Houman1368/Waste/uvc-arm-stand/docs/specifications.html

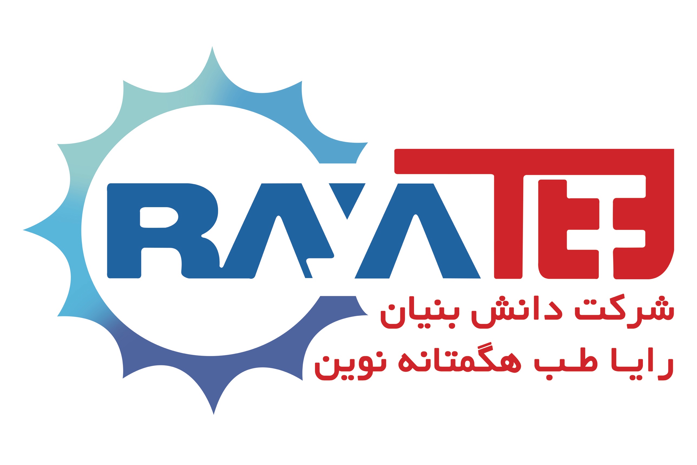
[picture p5: uvc-arm-stand/video/assets/logo_rayateb.jpg]
Rayateb


# مشخصات فنی کامل

پایه UV-C چهاربازو ۳۰ وات · طرح نهایی · ۱۸ مهر ۱۴۰۵ · همهٔ ابعاد به میلی‌متر

### فهرست

1. مشخصات کلی دستگاه
2. نقشهٔ کلی و نقشهٔ سیم‌کشی
3. نقشه و مشخصات قطعات ساختنی
4. مشخصات فنی قطعات برقی
5. مشخصات فنی یراق و قطعات مکانیکی خریدنی
6. پیچ و مهره، استاندارد و گشتاور
7. جوشکاری، تلرانس و رنگ
8. تست‌های تحویل

## ۱. مشخصات کلی دستگاه

پارامتر | مقدار
نوع دستگاه | پایهٔ سیار ضدعفونی سطوح و هوا با ۴ لامپ UV-C، چهار بازوی مستقل
لامپ | ۴ × UV-C T8، ۳۰ وات، ۲۵۳٫۷ نانومتر، پایه G13
برق ورودی | ۲۳۰ ولت AC، ۵۰ هرتز، تک‌فاز با ارت
توان مصرفی | حدود ۱۳۵ تا ۱۴۰ وات (۴ × ۳۰ وات + تلفات باالست)؛ جریان حدود ۰٫۷ آمپر
فیوز ورودی | T2A (کندسوز)
کلاس حفاظت الکتریکی | کلاس I (بدنهٔ فلزی ارت‌شده)
ابعاد پایه | ۵۰۰ × ۴۰۰، روی ۴ چرخ Ø۷۵ (۲ ترمزدار)
ستون | ۱۶۰ × ۱۲۰ × ۱۰۵۰ ورق فولادی ۱٫۵
ارتفاع محور لولا | ۱۱۵۰ از کف
ارتفاع در حالت پارک (حمل) | حدود ۱۲۱۵
ارتفاع کل، بازوها عمودی | ۲۰۶۰
دهانهٔ کل، بازوها افقی | ۲۰۲۰
طول هر بازو | ۹۵۰ (ناودانی ۶۰ × ۴۵ آلومینیوم ۱ آینه‌ای)
زاویهٔ بازو | ۰ تا ۱۸۰ درجه، ۱۳ موقعیت قفل (هر ۱۵ درجه) با پین فنری
قرارداد زاویه | ۰ = بازو رو به پایین کنار ستون (پارک)، ۹۰ = افقی، ۱۸۰ = عمودی رو به بالا
وزن تخمینی | حدود ۳۸ کیلوگرم (سازه ۲۷، چهار بازو ۶٫۴، قطعات برقی و چرخ ۵)
پایداری | ضریب اطمینان واژگونی حدود ۷٫۷ با دو بازوی یک طرف افقی؛ جابه‌جایی فقط با بازوهای پارک
ایمنی | تأخیر شروع ۳۰ تا ۶۰ ثانیه، قطع فوری با سنسور حرکت PIR (روشن شدن دوباره فقط دستی)، استاپ اضطراری، کلید قفل‌دار، چراغ هشدار، ساعت‌شمار لامپ
رنگ | رنگ پودری الکترواستاتیک روی قطعات فولادی؛ بازوهای آلومینیومی بدون رنگ

## ۲. نقشهٔ کلی و نقشهٔ سیم‌کشی





### مدار ایمنی (روشن/خاموش)

1. دوشاخه ← فیوز T2A ← استاپ اضطراری (NC) ← کلید سوئیچی ← تایمر.
2. تایمر بعد از ۳۰ تا ۶۰ ثانیه تأخیر، رلهٔ K1 را روشن می‌کند. K1 با کنتاکت خودش نگه داشته می‌شود (مدار خودنگه‌دار).
3. کنتاکت NC سنسور PIR در مسیر نگه‌دارندهٔ K1 است. با دیدن حرکت، K1 قطع می‌شود و دیگر خودش روشن نمی‌شود. فقط با خاموش و روشن کردن کلید سوئیچی دوباره شروع می‌شود.
4. چراغ هشدار و ساعت‌شمار موازی خروجی K1 هستند.
5. ارت به ستون، صفحهٔ پایه، جعبهٔ باالست و هر بازو وصل می‌شود. ارت بازو از طریق پیچ محور با واشر دندانه‌دار یا یک سیم جدا.

نقشهٔ سیم‌کشی دقیق، شامل شمارهٔ ترمینال‌ها، را برق‌کار باید بر اساس تایمر، رله و PIR خریداری‌شده بکشد. این بخش فقط منطق مدار را مشخص می‌کند.

## ۳. نقشه و مشخصات قطعات ساختنی

تلرانس عمومی (اگر روی نقشه چیز دیگری نوشته نشده): ISO 2768-m. برش لیزر ±۰٫۲، موقعیت سوراخ ±۰٫۲، خم ±۰٫۵ و زاویهٔ خم ±۱ درجه. جنس فولاد: S235 (ST37). آلومینیوم: ۱۰۵۰ یا ۵۰۰۵ با رویهٔ آینه‌ای یا آنودایز براق. فایل‌های برش در پوشهٔ dxf/ و مدل سه‌بعدی در step/ است.

### T1 — صفحهٔ سر (۲ عدد)



جنس / ضخامت | فرآیند | نکات
فولاد S235، ۴ | لیزر، خزینه ۶ سوراخ از جلو، جوش ۲ مهرهٔ M12×1.5 پشت سوراخ پین | لبهٔ بالای T1 ۲۸ بالاتر از سر ستون است. مهرهٔ جوشی باید کاملاً هم‌محور سوراخ Ø۶٫۵ باشد

### H2 — دیسک تقسیم (۴ عدد)



جنس / ضخامت | فرآیند | نکات
فولاد S235، ۵ | لیزر ۱۳ سوراخ Ø۵٫۸، بعد مته یا برقو Ø۶٫۲ | لقی پین ±۰٫۱ یعنی حدود ±۲ میلی‌متر در نوک بازو. هر ۴ دیسک یکسان‌اند؛ برای بازوهای چپ، دیسک برعکس جوش داده می‌شود

### H1 — براکت U بازو (۴ عدد)



جنس / ضخامت | فرآیند | نکات
فولاد S235، ۴ | لیزر، خم U دو طرف ۹۰°، جوش دیسک H2 وسط کف | عرض داخلی U باید ۶۰ (+۰٫۵/۰) باشد تا بدون لقی روی ناودانی بنشیند. سوراخ Ø۱۴ دیسک و براکت با میلهٔ Ø۱۴ هم‌محور شوند

### A1 — بدنهٔ بازو، ناودانی رفلکتور (۴ عدد)



جنس / ضخامت | فرآیند | نکات
آلومینیوم ۱، رویهٔ آینه‌ای یا آنودایز براق | لیزر یا گیوتین + سوراخ، خم ۴ خط | رویهٔ براق داخل ناودانی است. لبه‌های ۱۰ به داخل برمی‌گردند. محور لامپ ۲۵ از کف ناودانی است. کابل سمت دور پشت یک تسمهٔ پوشش ۱۵ میلی‌متری در کف ناودانی رد می‌شود تا نور مستقیم به آن نخورد

### A2 — درپوش سر بازو (۸ عدد)



جنس / ضخامت | فرآیند | نکات
آلومینیوم ۱ | لیزر، خم ۴ لبهٔ ۱۰ به ۹۰° | با پرچ ۴ میلی به ناودانی بسته می‌شود. سرپیچ G13 روی آن پیچ می‌شود؛ سوراخ‌هایش را از روی سرپیچ خریده‌شده بزنید. فاصلهٔ داخلی دو سرپیچ نصب‌شده: ۹۰۸ ±۲ با لامپ واقعی

### B1 — صفحهٔ پایه (۱ عدد)



جنس / ضخامت | فرآیند | نکات
فولاد S235، ۶ | لیزر | الگوی سوراخ چرخ (۴۵×۴۵) فرضی است؛ با چرخ واقعی تطبیق دهید. چرخ‌های ترمزدار در یک قطر

### C1 — فلنج ستون و لچکی‌ها



جنس / ضخامت | فرآیند | نکات
فلنج: فولاد ۶ — لچکی: فولاد ۴ | لیزر، جوش ستون دور تا دور، جوش ۴ لچکی وسط هر وجه | ستون باید کاملاً عمود بر فلنج باشد (حداکثر ۱ میلی‌متر انحراف در ۱ متر). ارتفاع لچکی ۶۰ است تا زیر سقف جعبهٔ باالست جا شود

### C1 — ستون (۱ عدد، از ۲ تکه U)



جنس / ضخامت | فرآیند | نکات
ورق فولادی ۱٫۵ | برش، خم ۲ تکه U (کف ۱۶۰ + دو لبهٔ ۶۰)، جوش نقطه‌ای هر ۵۰ یا پرچ، جوش درپوش ۴ میلی بالا | وجه‌های ۱۶۰ جلو و پشت‌اند. سوراخ‌های پرچ‌مهره را از روی خود T1 علامت بزنید. پنل روی وجه چپ، دسته روی وجه راست و درب سرویس روی وجه پشت است

### B2، C2، C3، دسته، درپوش ستون، بوش، گارد لامپ



قطعه | جنس / ضخامت | تعداد | نکات
B2 جعبهٔ باالست | ورق ۱٫۵ | ۱ | ۴۶۰×۳۶۰×۸۰، کف باز، سوراخ ستون ۱۷۰×۱۳۰؛ با ۴ نبشی کوچک و پیچ M5 به B1 بسته شود (برای سرویس باز شود)
C2 درب سرویس | ورق ۱٫۲ | ۱ | ۱۲۰×۶۰۰، ۴ پیچ؛ بازشوی ستون ۱۰۰×۵۸۰
C3 جعبهٔ پنل | ورق ۱٫۲ | ۱ | ۱۱۰×۱۸۰ با عمق ۶۰، رو به ستون باز؛ اگر قطعهٔ برقی عمیق‌تر بود، پشتش در ستون سوراخ شود
دستهٔ هل‌دادن | لوله Ø۲۵ + میله Ø۱۶ | ۱ | عمودی روی وجه راست، بالای آن ۱۰۰۰ از کف
درپوش ستون | فولاد ۴ | ۱ | ۱۶۰×۱۲۰، جوش
بوش برنجی | برنز CuSn | ۴ | Ø۱۰ H7 / Ø۱۴، طول ۱۰٫۲ (۰٫۲ بیشتر از ضخامت کف ناودانی + براکت + دیسک) تا پیچ روی بوش سفت شود و بازو آزاد بچرخد
A3 گارد لامپ | مفتول استیل Ø۳ | ۴ | ۵۰×۹۲۰ با مفتول عرضی هر ۱۲۰؛ با گیره روی لبه‌های ناودانی کلیپس شود

## ۴. مشخصات فنی قطعات برقی

قطعه | مشخصات فنی لازم | تعداد
لامپ UV-C | T8، ۳۰ وات، طول‌موج ۲۵۳٫۷ نانومتر، پایهٔ G13، طول حدود ۸۹۵ با پین، Ø۲۶. نوع بدون ازن (ozone-free) مگر اینکه ازن عمداً لازم باشد. عمر حدود ۹۰۰۰ ساعت؛ دیتاشیت با توان خروجی UV-C (وات) بگیرید | ۴ (+۱)
سرپیچ | G13 فنری (چرخشی)، بدنه سرامیکی یا فلزی مقاوم UV؛ ۲۵۰ ولت، ۲ آمپر | ۸
باالست الکترونیک | ورودی ۲۲۰–۲۴۰ ولت ۵۰/۶۰ هرتز، برای یک لامپ T8 سی‌وات (یا دوبل ۲×۳۰)، استارت با پیش‌گرم (preheat)، ضریب توان ≥۰٫۹، مناسب لامپ ژرمیسیدال | ۴ (یا ۲ دوبل)
تایمر دیجیتال | تغذیه ۲۳۰ VAC، قابلیت تأخیر در شروع (۳۰–۶۰ ثانیه) و زمان کار تا حداقل ۶۰ دقیقه، کنتاکت خروجی ≥۵ آمپر ۲۵۰ ولت؛ پنلی ۴۸×۴۸ یا ریلی | ۱
سنسور حرکت PIR | ۲۳۰ VAC، زاویهٔ دید ≥۱۱۰°، برد ≥۸ متر، خروجی رله‌ای (ترجیحاً NC در حالت تشخیص حرکت)، حساسیت قابل تنظیم | ۱ تا ۲
رلهٔ K1 | بوبین ۲۳۰ VAC، ۲ کنتاکت تبدیلی ۱۰ آمپر، با پایهٔ ریلی (یا مینی‌کنتاکتور) | ۱
شستی استاپ اضطراری | قارچی قرمز Ø۴۰، نصب Ø۲۲، کنتاکت ۱NC، آزادسازی با چرخش، با پلاک زرد | ۱
کلید سوئیچی | نصب Ø۲۲، دو حالتهٔ ماندگار، کنتاکت ۱NO، کلید فقط در حالت خاموش خارج شود | ۱
ساعت‌شمار کارکرد | ۲۳۰ VAC، ۵ یا ۶ رقمی، پنلی (۴۸×۲۴ یا گرد Ø۲۲) | ۱
چراغ هشدار | LED نصب Ø۲۲، ۲۳۰ VAC، قرمز یا بنفش، با برچسب «UV-C روشن است» | ۱
فیوز و جافیوزی | فیوز شیشه‌ای ۵×۲۰، T2A ۲۵۰ ولت، جافیوزی پنلی | ۱ (+۲ یدک)
کابل داخل بازو | سیلیکونی یا تفلونی ۴×۰٫۷۵ میلی‌متر مربع، ۳۰۰/۵۰۰ ولت، دمای کار تا ۱۸۰°C، مقاوم UV | ۸ متر
کابل ورودی برق | ۳×۱ میلی‌متر مربع (H05VV-F یا H05RR-F)، ۳ متر، با دوشاخهٔ ارت‌دار و گلند M16 (PG9) | ۱
ترمینال | ترمینال ریلی ۲٫۵ میلی‌متر مربع + ترمینال ارت + ریل امگا ۳۵ | ۱۲ + ۲
سیم ارت | زرد-سبز ۱٫۵ میلی‌متر مربع + سرسیم چشمی M5 | ۳ متر
برچسب‌ها | هشدار UV-C (نماد بین‌المللی)، «فقط در اتاق خالی»، پلاک مشخصات دستگاه | ۶

کابل PVC معمولی در محدودهٔ بازوها ممنوع است، چون UV-C آن را در مدت کوتاهی ترد می‌کند. هیچ قطعهٔ پلاستیکی نباید در معرض مستقیم نور لامپ باشد.

## ۵. مشخصات فنی یراق و قطعات مکانیکی خریدنی

قطعه | مشخصات فنی لازم | تعداد
پین فنری قفل (index plunger) | رزوهٔ M12×1.5، پین Ø۶ (تلرانس منفی، مثلاً h9)، کورس پین ≥۸، نیروی فنر حدود ۱۰ تا ۲۵ نیوتن، با حالت استراحت (lock-out؛ مثل GN 617.1 یا GN 817.1)، فولاد گالوانیزه یا استیل، قطر دسته ≤۲۵، با مهرهٔ قفل | ۴ (+۱)
چرخ گردان | Ø۷۵، روکش پلی‌یورتان، صفحه‌دار (حدود ۶۰×۶۰، سوراخ‌ها حدود ۴۵×۴۵ Ø۸–۹)، ارتفاع کل حدود ۱۰۰، ظرفیت ≥۳۰ کیلو برای هر چرخ | ۲
چرخ گردان ترمزدار | همان مدل با ترمز کامل (چرخ + گردش) | ۲
واشر تفلونی | PTFE، Ø۳۰ / Ø۱۴٫۲ × ۱ | ۴
پرچ‌مهره (ریوت‌نات) | M8، فولادی گالوانیزه، مناسب ورق ۰٫۵ تا ۳ میلی، سوراخ Ø۱۰؛ به‌علاوهٔ انبر پرچ‌مهره | ۱۲ (+۴)
گرومت | لاستیکی برای سوراخ Ø۱۶ در ورق ۱٫۵ (۲ عدد)؛ فلزی یا گلند برای سوراخ Ø۱۰ در آلومینیوم ۱ (۴ عدد) | ۲ + ۴
لوله و میله | لوله Ø۲۵ (ضخامت ۱٫۵–۲) طول ۳۰۰؛ میلهٔ Ø۱۶ طول ۲×۵۰ | ۱
مفتول | استیل ۳۰۴ Ø۳ | ۱۰ متر
گیرهٔ گارد | گیرهٔ فنری استیل برای لبهٔ ۱ میلی | ۱۶

## ۶. پیچ و مهره، استاندارد و گشتاور سفت کردن

محل | پیچ / مهره | استاندارد و جنس | تعداد | گشتاور
محور لولا | پیچ سرگرد آلن M10×30 + مهرهٔ نایلون‌دار M10 + ۲ واشر تخت + ۱ واشر دندانه‌دار (ارت) | ISO 7380 / DIN 985 / DIN 125، گرید ۸٫۸ گالوانیزه | ۴ | ۲۵ نیوتن‌متر*
پین فنری | مهرهٔ جوشی M12×1.5 | DIN 929 (شش‌گوش جوشی) فولادی | ۴ | پین با لاک‌تایت ۲۴۳
صفحهٔ سر به ستون | پیچ خزینه آلن M8×12 در پرچ‌مهره | ISO 10642، گرید ۸٫۸ | ۱۲ | ۱۲ نیوتن‌متر
فلنج ستون به صفحهٔ پایه | پیچ M10×30 + مهره + ۲ واشر | ISO 4017 / ISO 4032، گرید ۸٫۸ | ۴ | ۴۵ نیوتن‌متر
چرخ‌ها | پیچ M8×20 + مهرهٔ نایلون‌دار + واشر | ISO 4017 / DIN 985، گرید ۸٫۸ | ۱۶ | ۲۰ نیوتن‌متر
براکت به ناودانی | پیچ سرگرد M5×12 + مهرهٔ نایلون‌دار + واشر | ISO 7380 / DIN 985، استیل A2 | ۱۶ | ۴ نیوتن‌متر
درپوش سر بازو | پرچ پاپ Ø۴ × ۸ | آلومینیومی | ۳۲ | —
سرپیچ روی درپوش | پیچ M4 + مهرهٔ نایلون‌دار (طبق سوراخ سرپیچ) | استیل A2 | ۱۶ | ۱٫۵ نیوتن‌متر
درب، جعبهٔ پنل، جعبهٔ باالست | پیچ M5 یا پیچ خودکار ۴٫۲ | گالوانیزه | ۲۰ | دستی

* محور لولا: بوش برنجی ۰٫۲ میلی‌متر از ضخامت قطعات روی محور بلندتر است، پس پیچ روی بوش سفت می‌شود و بازو آزاد می‌چرخد. اگر بعد از سفت کردن بازو سفت چرخید، بوش کوتاه است.

## ۷. جوشکاری، تلرانس و رنگ

مورد | مشخصات
روش جوش | MAG (CO2)، سیم Ø۰٫۸؛ ورق ۱٫۵ با جریان کم یا جوش نقطه‌ای
ستون به فلنج | گوشه‌ای a3 دور تا دور
لچکی‌ها | گوشه‌ای a3 دو طرف، روی فلنج و ستون
درز ستون (دو U) | جوش نقطه‌ای هر ۵۰ یا پرچ Ø۴ هر ۸۰
درپوش ستون | گوشه‌ای a2 دور تا دور
دیسک به براکت | گوشه‌ای a3 دور کف براکت؛ اول با میلهٔ Ø۱۴ هم‌محور کنید، چهار نقطه خال بزنید، بعد جوش کامل
مهرهٔ جوشی M12 | سه نقطه یا دور تا دور؛ پیش از جوش با پین هم‌محور کنید؛ پاشش جوش داخل رزوه نرود
تلرانس عمومی | ISO 2768-m؛ ستون عمود بر فلنج ±۱ در ۱۰۰۰؛ دو صفحهٔ سر موازی ±۱
آماده‌سازی رنگ | چربی‌گیری و فسفاته یا سندبلاست
رنگ پودری | پلی‌استر، ضخامت ۶۰–۸۰ میکرون، RAL 9016 (سفید) یا RAL 7035 (طوسی روشن)
ماسک قبل از رنگ | رزوهٔ مهره‌های M12، پرچ‌مهره‌ها، سوراخ‌های Ø۱۴ و ۱۳ سوراخ دیسک، و یک نقطهٔ ارت روی ستون، پایه و هر براکت
آلومینیوم | بدون رنگ؛ محافظ نایلونی تا مونتاژ نهایی بماند

## ۸. تست‌های تحویل

تست | معیار قبولی
چرخش بازوها | روان و بدون لقی محوری؛ قفل در هر ۱۳ موقعیت؛ لقی نوک بازو در حالت قفل ≤ ±۳
فاصلهٔ بازوی پارک | نوک بازو حداقل ۵۰ بالای جعبهٔ باالست
پایداری | دو بازوی یک طرف افقی، هل ملایم از بالا: دستگاه واژگون نمی‌شود
پیوستگی ارت | مقاومت بین پین ارت دوشاخه و هر بازو، ستون و پایه ≤ ۰٫۱ اهم
مقاومت عایقی | با میگر ۵۰۰ ولت DC بین فاز/نول و بدنه ≥ ۲ مگااهم
تأخیر شروع | لامپ‌ها ۳۰ تا ۶۰ ثانیه بعد از روشن کردن کلید روشن می‌شوند
قطع با PIR | با حرکت جلوی سنسور، لامپ‌ها فوراً خاموش می‌شوند و خودبه‌خود روشن نمی‌شوند
استاپ اضطراری | با فشار، همه چیز فوراً قطع می‌شود
ساعت‌شمار و چراغ هشدار | فقط وقتی لامپ‌ها روشن‌اند کار می‌کنند
شدت تابش | با UV-C متر یا کارت اندیکاتور در فاصلهٔ ۱ متر اندازه بگیرید و زمان لازم برای دوز هدف را ثبت کنید

ایمنی: UV-C در چند ثانیه به پوست و چشم آسیب می‌زند. در همهٔ تست‌های روشن، عینک و دستکش ضد UV بپوشید و کسی جلوی لامپ نباشد.
