Houman1368/Waste/uvc-arm-stand/docs/UV-C_stand_full_specifications.pdf

مشخصات فنی کامل

پایه C-UV چهاربازو ۳۰ وات · طرح نهایی · ۱۸ مهر ۱۴۰۵ · همٔه ابعاد به میلیمتر

فهرست
.1 مشخصات کلی دستگاه

.2 نقشٔه کلی و نقشٔه سیمکشی

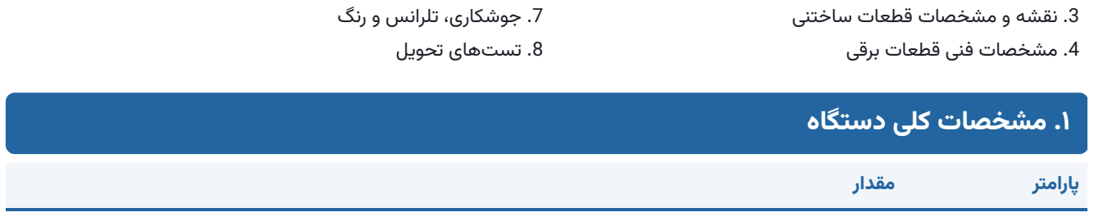
[picture p6: figure]
.4 مشخصات فنی قطعات برقی; .7 جوشکاری، تلرانس و رنگ .8 تستهای تحویل; .۱ مشخصات کلی دستگاه; پارامتر مقدار

.3 نقشه و مشخصات قطعات ساختنی

.5 مشخصات فنی یراق و قطعات مکانیکی خریدنی .6 پیچ و مهره، استاندارد و گشتاور

نوع دستگاه پایٔه سیار ضدعفونی سطوح و هوا با ۴ المپ C-UV، چهار بازوی مستقل المپ ۴ × ۳۰ 8،T C-UV وات، ۲۵۳٫۷ نانومتر، پایه 13G برق ورودی ۲۳۰ ولت ۵۰ ،AC هرتز، تکفاز با ارت توان مصرفی حدود ۱۳۵ تا ۱۴۰ وات )۴ × ۳۰ وات + تلفات باالست(؛ جریان حدود ۰٫۷ آمپر فیوز ورودی A2T( کندسوز(

کالس حفاظت

الکتریکی

کالس I( بدنٔه فلزی ارتشده(

ابعاد پایه ۵۰۰ × ،۴۰۰ روی ۴ چرخ ۷۵Ø( ۲ ترمزدار( ستون ۱۶۰ × ۱۲۰ × ۱۰۵۰ ورق فوالدی ۱٫۵ ارتفاع محور لوال ۱۱۵۰ از کف ارتفاع در حالت پارک

)حمل(

حدود ۱۲۱۵

ارتفاع کل، بازوها
عمودی

۲۰۶۰

دهانٔه کل، بازوها افقی ۲۰۲۰ طول هر بازو ۹۵۰ )ناودانی ۶۰ × ۴۵ آلومینیوم ۱ آینهای( زاویٔه بازو ۰ تا ۱۸۰ درجه، ۱۳ موقعیت قفل )هر ۱۵ درجه( با پین فنری قرارداد زاویه ۰ = بازو رو به پایین کنار ستون )پارک(، ۹۰ = افقی، ۱۸۰ = عمودی رو به باال وزن تخمینی حدود ۳۸ کیلوگرم )سازه ،۲۷ چهار بازو ،۶٫۴ قطعات برقی و چرخ ۵( پایداری ضریب اطمینان واژگونی حدود ۷٫۷ با دو بازوی یک طرف افقی؛ جابهجایی فقط با بازوهای پارک ایمنی تأخیر شروع ۳۰ تا ۶۰ ثانیه، قطع فوری با سنسور حرکت PIR( روشن شدن دوباره فقط دستی(، استاپ اضطراری، کلید قفلدار، چراغ هشدار، ساعتشمار المپ رنگ رنگ پودری الکترواستاتیک روی قطعات فوالدی؛ بازوهای آلومینیومی بدون رنگ

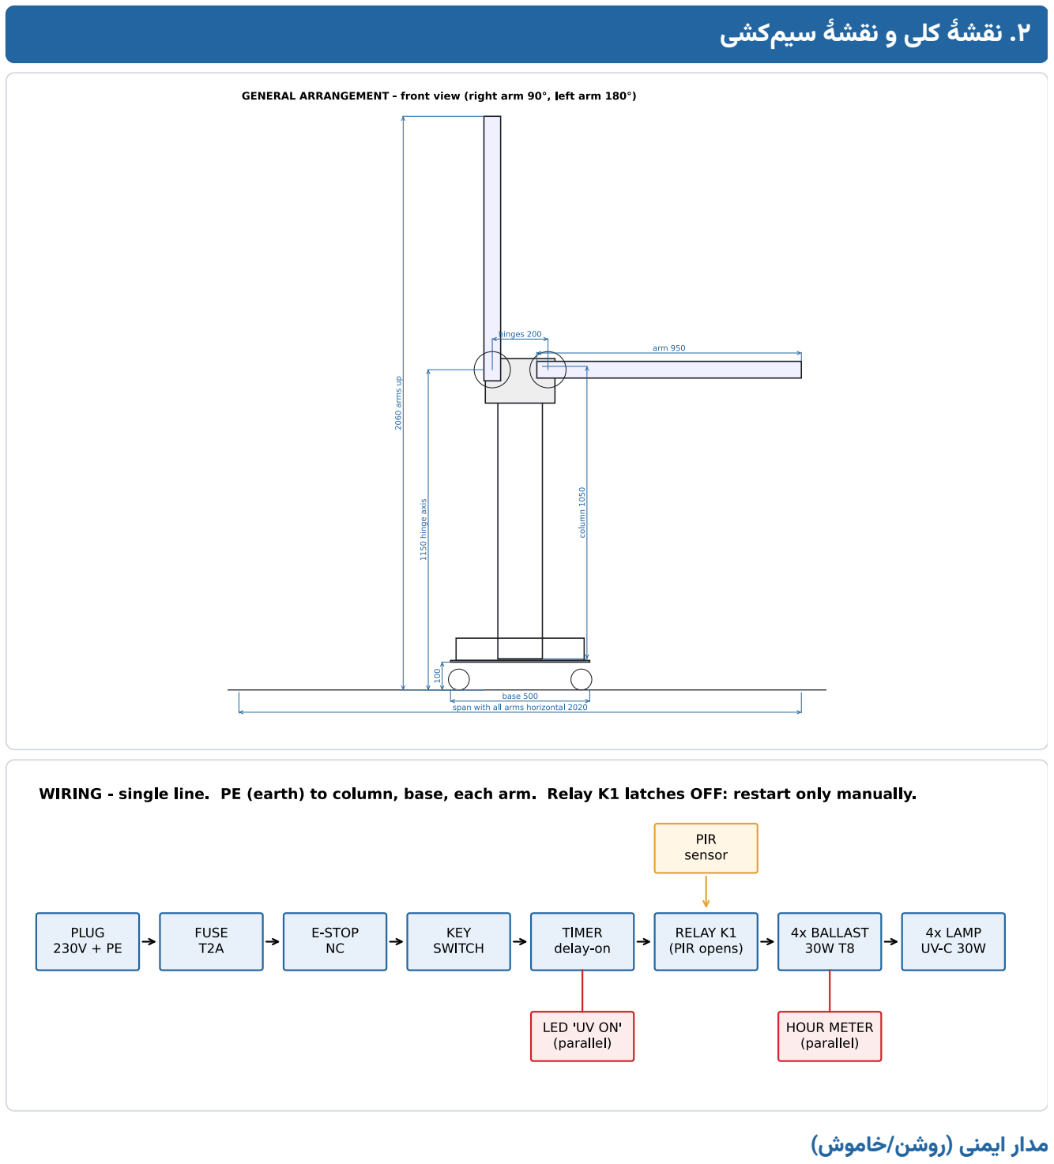
[picture p7: figure]
.۲ نقشٔه کلی و نقشٔه سیمکشی; مدار ایمنی )روشن/خاموش(

.1 دوشاخه ← فیوز A2T ← استاپ اضطراری )NC ← )کلید سوئیچی ← تایمر. .2 تایمر بعد از ۳۰ تا ۶۰ ثانیه تأخیر، رلٔه 1K را روشن میکند. 1K با کنتاکت خودش نگه داشته میشود )مدار خودنگهدار(. .3 کنتاکت NC سنسور PIR در مسیر نگهدارندٔه 1K است. با دیدن حرکت، 1K قطع میشود و دیگر خودش روشن نمیشود. فقط با خاموش و روشن کردن کلید سوئیچی دوباره شروع میشود. .4 چراغ هشدار و ساعتشمار موازی خروجی 1K هستند. .5 ارت به ستون، صفحٔه پایه، جعبٔه باالست و هر بازو وصل میشود. ارت بازو از طریق پیچ محور با واشر دندانهدار یا یک سیم جدا.

نقشٔه سیمکشی دقیق، شامل شمارٔه ترمینالها، را برقکار باید بر اساس تایمر، رله و PIR خریداریشده بکشد. این بخش فقط منطق

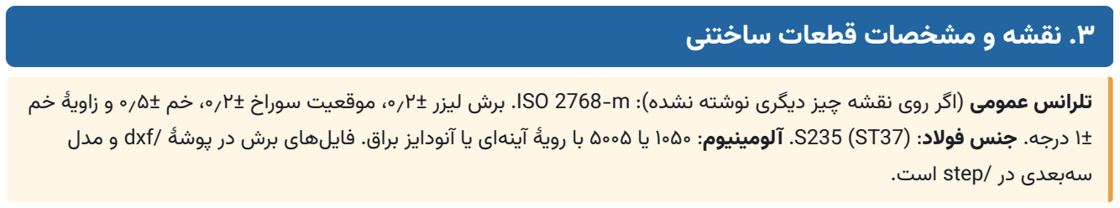
[picture p8: figure]
.۳ نقشه و مشخصات قطعات ساختنی; سهبعدی در /step است.

تلرانس عمومی )اگر روی نقشه چیز دیگری نوشته نشده(: m2768- ISO. برش لیزر ،۰٫۲± موقعیت سوراخ ،۰٫۲± خم ۰٫۵± و زاویٔه خم ۱± درجه. جنس فوالد: (37ST (235S. آلومینیوم: ۱۰۵۰ یا ۵۰۰۵ با رویٔه آینهای یا آنودایز براق. فایلهای برش در پوشٔه /dxf و مدل

1T — صفحٔه سر )۲ عدد(

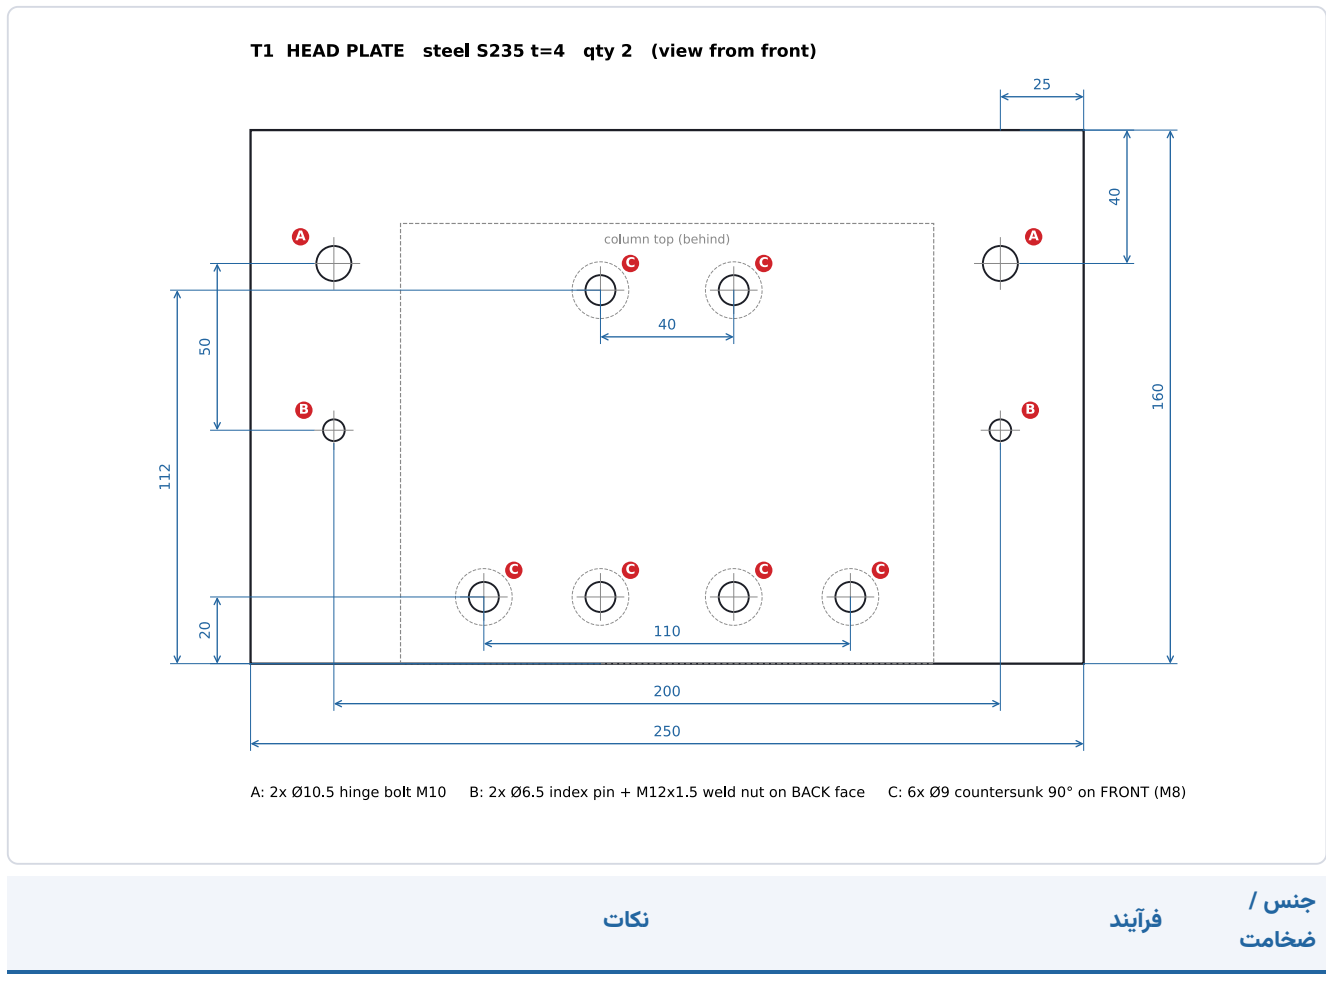
[picture p9: figure]
جنس /; ضخامت; فرآیند نکات

فوالد ۴ 235،S لیزر، خزینه ۶ سوراخ از جلو، جوش ۲ مهرٔه 1.5×12M پشت سوراخ پین

لبٔه باالی ۲۸ 1T باالتر از سر ستون است. مهرٔه جوشی باید کام ًال
هممحور سوراخ ۶٫۵Ø باشد

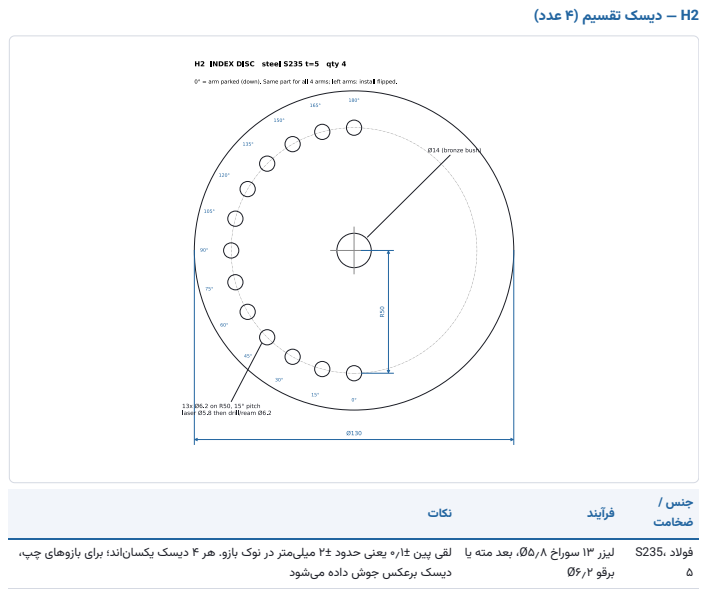
[picture p10: page 4]
جنس /; ضخامت; فرآیند نکات; فوالد 235،S ۵; برقو ۶٫۲Ø

2H — دیسک تقسیم )۴ عدد(

لقی پین ۰٫۱± یعنی حدود ۲± میلیمتر در نوک بازو. هر ۴ دیسک یکساناند؛ برای بازوهای چپ،

لیزر ۱۳ سوراخ ۵٫۸Ø، بعد مته یا

دیسک برعکس جوش داده میشود

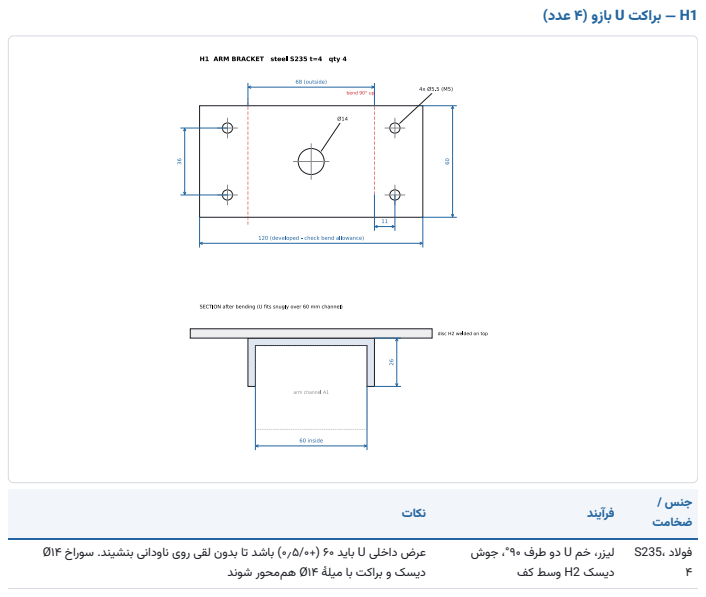
[picture p11: page 5]
جنس /; ضخامت; فرآیند نکات; فوالد 235،S ۴

1H — براکت U بازو )۴ عدد(

عرض داخلی U باید ۶۰ )۰٫۵/۰+( باشد تا بدون لقی روی ناودانی بنشیند. سوراخ ۱۴Ø

لیزر، خم U دو طرف ،°۹۰ جوش
دیسک 2H وسط کف

دیسک و براکت با میلٔه ۱۴Ø هممحور شوند

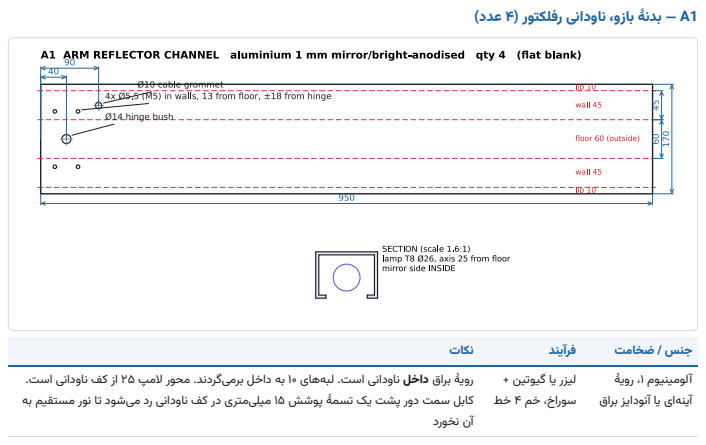
[picture p12: page 6]
آن نخورد

1A — بدنٔه بازو، ناودانی رفلکتور )۴ عدد(

جنس / ضخامت فرآیند نکات
لیزر یا گیوتین +
سوراخ، خم ۴ خط

رویٔه براق داخل ناودانی است. لبههای ۱۰ به داخل برمیگردند. محور المپ ۲۵ از کف ناودانی است.
کابل سمت دور پشت یک تسمٔه پوشش ۱۵ میلیمتری در کف ناودانی رد میشود تا نور مستقیم به

آلومینیوم ،۱ رویٔه
آینهای یا آنودایز براق

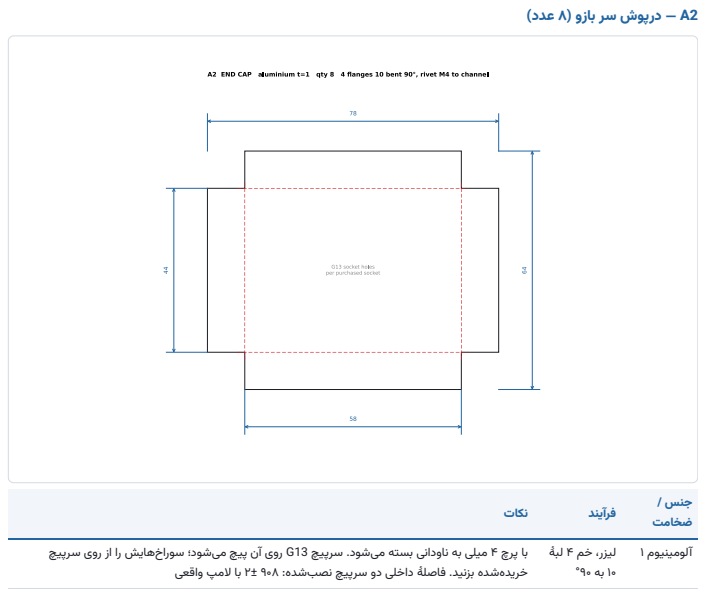
[picture p13: page 7]
جنس /; ضخامت; فرآیند نکات

2A — درپوش سر بازو )۸ عدد(

با پرچ ۴ میلی به ناودانی بسته میشود. سرپیچ 13G روی آن پیچ میشود؛ سوراخهایش را از روی سرپیچ

آلومینیوم ۱ لیزر، خم ۴ لبٔه

خریدهشده بزنید. فاصلٔه داخلی دو سرپیچ نصبشده: ۹۰۸ ۲± با المپ واقعی

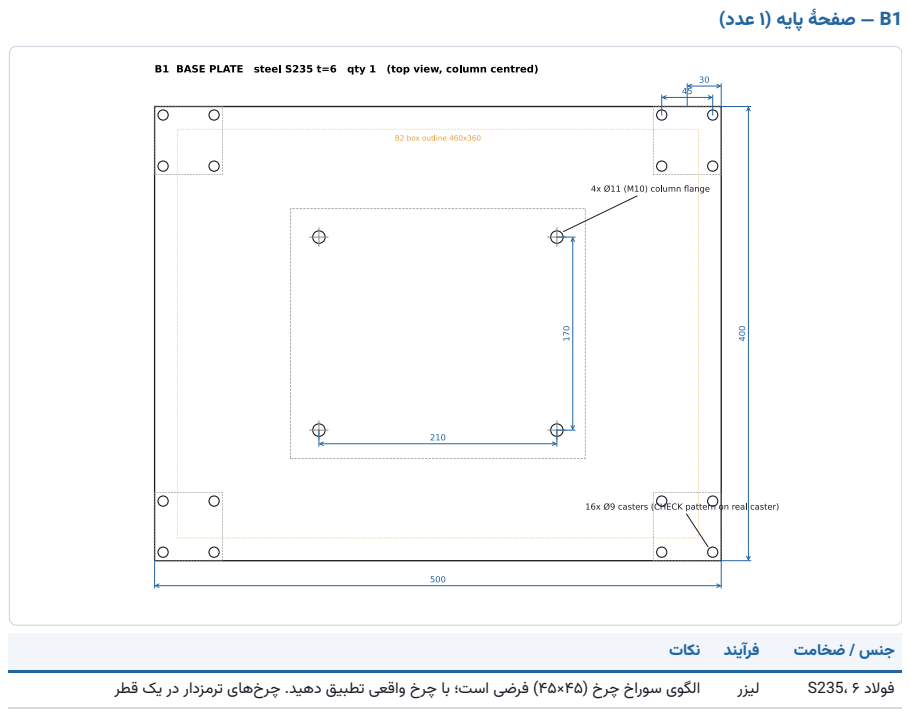
[picture p14: page 8]

1B — صفحٔه پایه )۱ عدد(

جنس / ضخامت فرآیند نکات

فوالد ۶ 235،S لیزر الگوی سوراخ چرخ )۴۵×۴۵( فرضی است؛ با چرخ واقعی تطبیق دهید. چرخهای ترمزدار در یک قطر

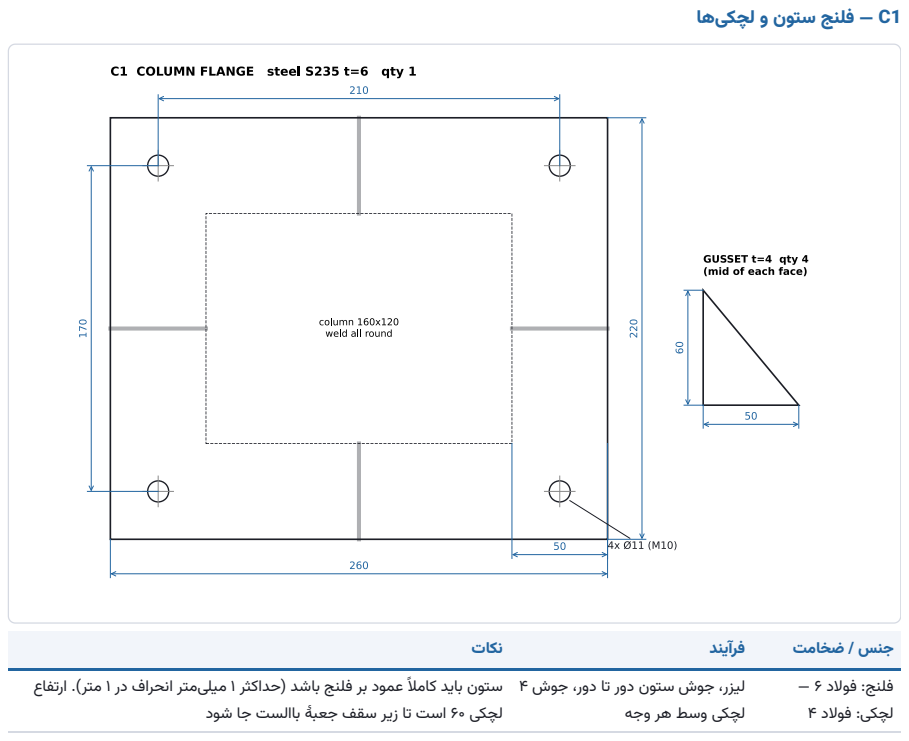
[picture p15: page 9]
فلنج: فوالد ۶ —; لچکی: فوالد ۴

1C — فلنج ستون و لچکیها

جنس / ضخامت فرآیند نکات
لیزر، جوش ستون دور تا دور، جوش ۴

ستون باید کام ًال عمود بر فلنج باشد )حداکثر ۱ میلیمتر انحراف در ۱ متر(. ارتفاع

لچکی ۶۰ است تا زیر سقف جعبٔه باالست جا شود

لچکی وسط هر وجه

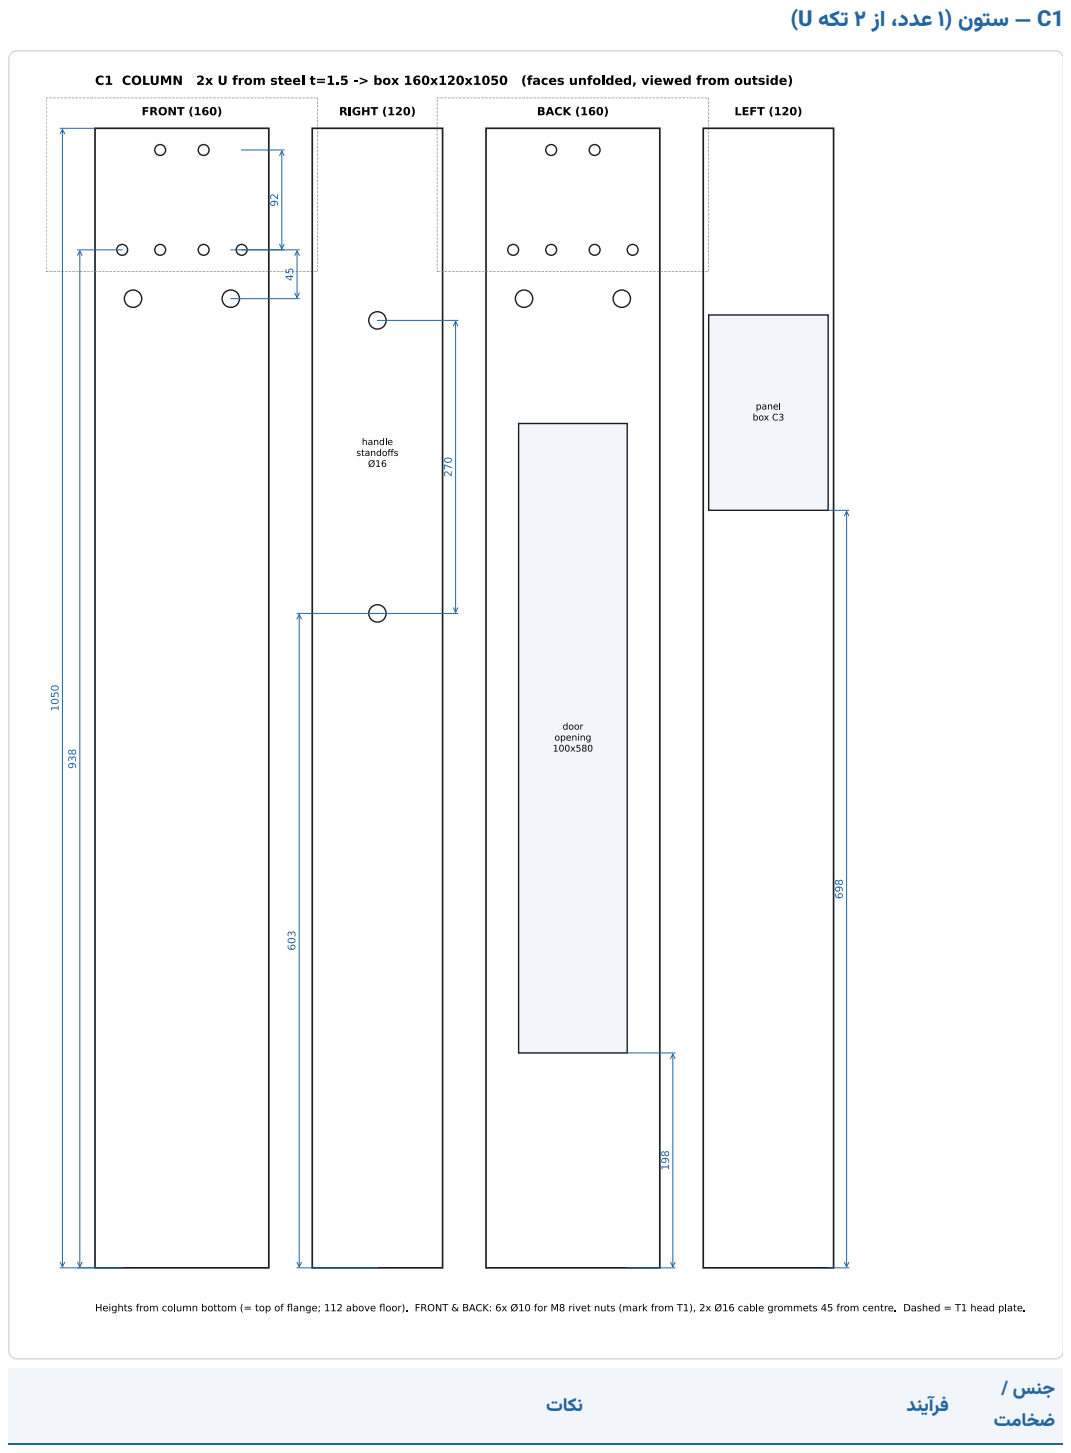
[picture p16: page 10]
جنس /; ضخامت; فرآیند نکات

1C — ستون )۱ عدد، از ۲ تکه U)

ورق فوالدی
۱٫۵

برش، خم ۲ تکه U( کف ۱۶۰ + دو لبٔه ۶۰(، جوش نقطهای هر ۵۰ یا پرچ، جوش درپوش ۴ میلی باال

وجههای ۱۶۰ جلو و پشتاند. سوراخهای پرچمهره را از روی خود 1T عالمت بزنید. پنل روی وجه چپ، دسته روی وجه راست و درب سرویس روی وجه پشت است

3C 2،C 2،B، دسته، درپوش ستون، بوش، گارد المپ

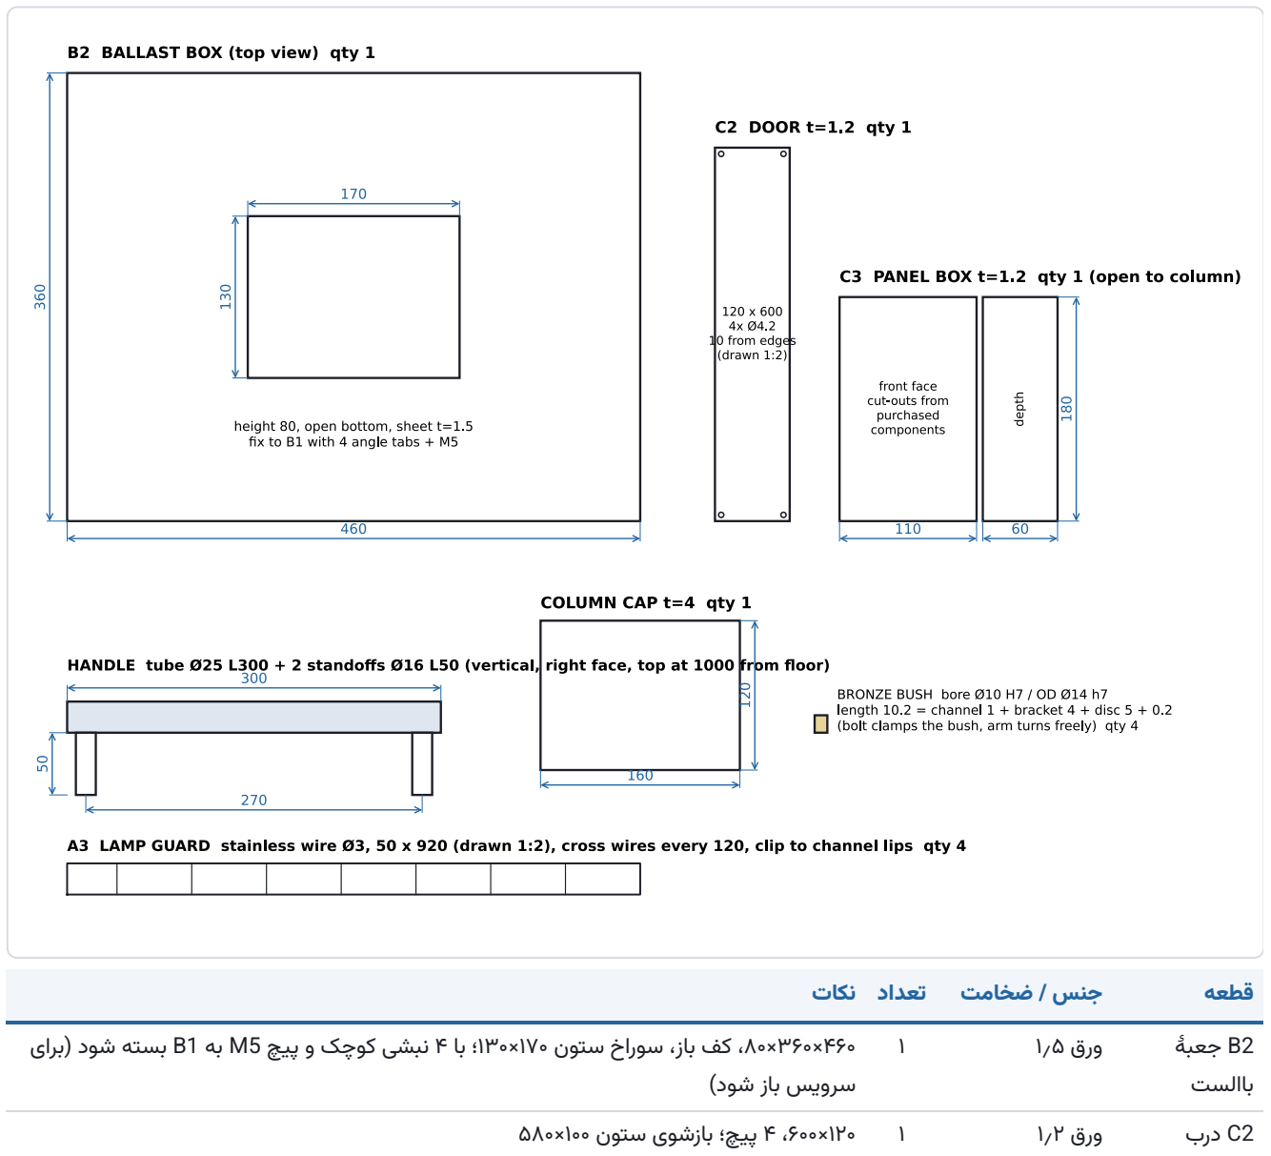
[picture p17: figure]
قطعه جنس / ضخامت تعداد نکات; 2B جعبٔه; باالست; سرویس باز شود(; 2C درب

ورق ۱٫۵ ۱ ۴۶۰×۳۶۰×،۸۰ کف باز، سوراخ ستون ۱۷۰×۱۳۰؛ با ۴ نبشی کوچک و پیچ 5M به 1B بسته شود )برای

سرویس

ورق ۱٫۲ ۱ ۱۲۰×،۶۰۰ ۴ پیچ؛ بازشوی ستون ۱۰۰×۵۸۰

3C جعبٔه پنل ورق ۱٫۲ ۱ ۱۱۰×۱۸۰ با عمق ،۶۰ رو به ستون باز؛ اگر قطعٔه برقی عمیقتر بود، پشتش در ستون سوراخ شود دستٔه هلدادن لوله ۲۵Ø + میله Ø۱۶

۱ عمودی روی وجه راست، باالی آن ۱۰۰۰ از کف

درپوش ستون فوالد ۴ ۱ ۱۶۰×،۱۲۰ جوش بوش برنجی برنز CuSn ۴ ۱۴Ø / 7H ۱۰Ø، طول ۱۰٫۲ )۰٫۲ بیشتر از ضخامت کف ناودانی + براکت + دیسک( تا پیچ روی بوش سفت شود و بازو آزاد بچرخد
3A گارد المپ مفتول استیل ۳Ø ۴ ۵۰×۹۲۰ با مفتول عرضی هر ۱۲۰؛ با گیره روی لبههای ناودانی کلیپس شود

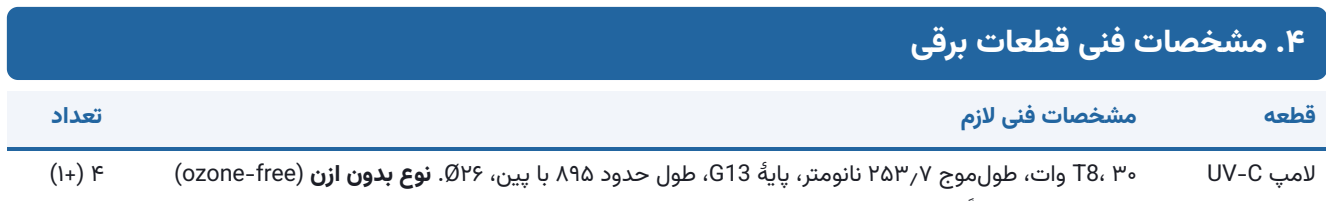
[picture p18: figure]
.۴ مشخصات فنی قطعات برقی; قطعه مشخصات فنی الزم تعداد

المپ C-UV ۳۰ 8،T وات، طولموج ۲۵۳٫۷ نانومتر، پایٔه 13G، طول حدود ۸۹۵ با پین، ۲۶Ø. نوع بدون ازن )free-ozone) مگر اینکه ازن عمدًا الزم باشد. عمر حدود ۹۰۰۰ ساعت؛ دیتاشیت با توان خروجی C-UV( وات( بگیرید
سرپیچ 13G فنری )چرخشی(، بدنه سرامیکی یا فلزی مقاوم UV؛ ۲۵۰ ولت، ۲ آمپر ۸

باالست

الکترونیک

ورودی ۲۲۰–۲۴۰ ولت ۵۰/۶۰ هرتز، برای یک المپ 8T سیوات )یا دوبل ۲×۳۰(، استارت با پیشگرم )preheat)،
ضریب توان ≤،۰٫۹ مناسب المپ ژرمیسیدال

۴ )یا ۲ دوبل(

تایمر دیجیتال تغذیه ۲۳۰ VAC، قابلیت تأخیر در شروع )۳۰–۶۰ ثانیه( و زمان کار تا حداقل ۶۰ دقیقه، کنتاکت خروجی ≤۵ آمپر ۲۵۰ ولت؛ پنلی ۴۸×۴۸ یا ریلی

۱

سنسور حرکت
PIR

۲۳۰ VAC، زاویٔه دید ≤،°۱۱۰ برد ≤۸ متر، خروجی رلهای )ترجیحًا NC در حالت تشخیص حرکت(، حساسیت قابل

تنظیم

۱ تا ۲

رلٔه 1K بوبین ۲۳۰ ۲ ،VAC کنتاکت تبدیلی ۱۰ آمپر، با پایٔه ریلی )یا مینیکنتاکتور( ۱ شستی استاپ
اضطراری

قارچی قرمز ۴۰Ø، نصب ۲۲Ø، کنتاکت NC،۱ آزادسازی با چرخش، با پالک زرد ۱

کلید سوئیچی نصب ۲۲Ø، دو حالتٔه ماندگار، کنتاکت NO،۱ کلید فقط در حالت خاموش خارج شود ۱

ساعتشمار

کارکرد

۲۳۰ ۵ ،VAC یا ۶ رقمی، پنلی )۴۸×۲۴ یا گرد ۲۲Ø )۱

چراغ هشدار LED نصب VAC ۲۳۰ ۲۲،Ø، قرمز یا بنفش، با برچسب »C-UV روشن است« ۱ فیوز و جافیوزی فیوز شیشهای ۵×،۲۰ ۲۵۰ A2T ولت، جافیوزی پنلی ۱ )۲+ یدک( کابل داخل بازو سیلیکونی یا تفلونی ۴×۰٫۷۵ میلیمتر مربع، ۳۰۰/۵۰۰ ولت، دمای کار تا °۱۸۰C، مقاوم UV ۸ متر کابل ورودی برق ۳×۱ میلیمتر مربع )F-VV05H یا F-RR05H)، ۳ متر، با دوشاخٔه ارتدار و گلند (9PG (16M ۱ ترمینال ترمینال ریلی ۲٫۵ میلیمتر مربع + ترمینال ارت + ریل امگا ۳۵ ۱۲ + ۲ سیم ارت زرد-سبز ۱٫۵ میلیمتر مربع + سرسیم چشمی 5M ۳ متر برچسبها هشدار C-UV( نماد بینالمللی(، »فقط در اتاق خالی«، پالک مشخصات دستگاه ۶

کابل PVC معمولی در محدودٔه بازوها ممنوع است، چون C-UV آن را در مدت کوتاهی ترد میکند. هیچ قطعٔه پالستیکی نباید در

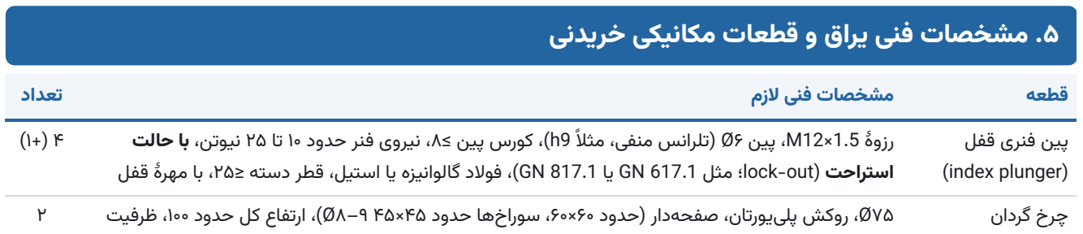
[picture p19: figure]
قطعه مشخصات فنی الزم تعداد; پین فنری قفل )index plunger(

.۵ مشخصات فنی یراق و قطعات مکانیکی خریدنی

رزؤه 1.5×12M، پین ۶Ø( تلرانس منفی، مث ًال 9h)، کورس پین ≤،۸ نیروی فنر حدود ۱۰ تا ۲۵ نیوتن، با حالت
استراحت )out-lock؛ مثل 617.1 GN یا 817.1 GN)، فوالد گالوانیزه یا استیل، قطر دسته ≥،۲۵ با مهرٔه قفل
چرخ گردان ۷۵Ø، روکش پلییورتان، صفحهدار )حدود ۶۰×،۶۰ سوراخها حدود ۴۵×۴۵ ۹–۸Ø)، ارتفاع کل حدود ،۱۰۰ ظرفیت

≤۳۰ کیلو برای هر چرخ
چرخ گردان ترمزدار همان مدل با ترمز کامل )چرخ + گردش( ۲
۴ | PTFE، Ø۳۰ / Ø۱۴٫۲ × ۱ | تفلونی | واشر
پرچمهره )ریوتنات( 8M، فوالدی گالوانیزه، مناسب ورق ۰٫۵ تا ۳ میلی، سوراخ ۱۰Ø؛ بهعالؤه انبر پرچمهره ۱۲ )۴+(

گرومت الستیکی برای سوراخ ۱۶Ø در ورق ۱٫۵ )۲ عدد(؛ فلزی یا گلند برای سوراخ ۱۰Ø در آلومینیوم ۱ )۴ عدد( ۲ + ۴ لوله و میله لوله ۲۵Ø( ضخامت ۱٫۵–۲( طول ۳۰۰؛ میلٔه ۱۶Ø طول ۲×۵۰ ۱ مفتول استیل ۳۰۴ ۳Ø ۱۰ متر
گیرٔه گارد گیرٔه فنری استیل برای لبٔه ۱ میلی ۱۶

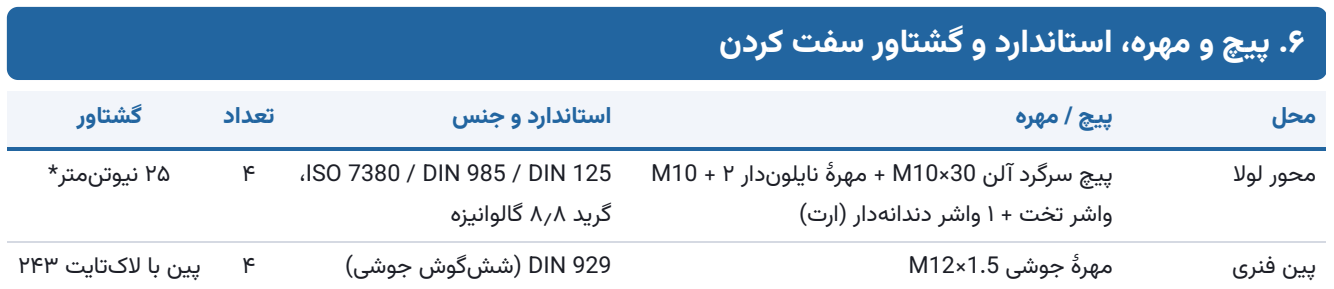
[picture p20: figure]
واشر تخت + ۱ واشر دندانهدار )ارت(; ،ISO 7380 / DIN 985 / DIN 125 گرید ۸٫۸ گالوانیزه; ۴ ۲۵ نیوتنمتر*; ۴ پین با الکتایت ۲۴۳

## .۶ پیچ و مهره، استاندارد و گشتاور سفت کردن

محل پیچ / مهره استاندارد و جنس تعداد گشتاور محور لوال پیچ سرگرد آلن 30×10M + مهرٔه نایلوندار ۲ + 10M

پین فنری مهرٔه جوشی 1.5×12M 929 DIN( ششگوش جوشی(

فوالدی
صفحٔه سر به ستون پیچ خزینه آلن 12×8M در پرچمهره 10642 ISO، گرید ۸٫۸ ۱۲ ۱۲ نیوتنمتر

فلنج ستون به

صفحٔه پایه

پیچ 30×10M + مهره + ۲ واشر 4032 ISO / 4017 ISO، گرید ۸٫۸ ۴ ۴۵ نیوتنمتر

چرخها پیچ 20×8M + مهرٔه نایلوندار + واشر 985 DIN / 4017 ISO، گرید ۸٫۸ ۱۶ ۲۰ نیوتنمتر براکت به ناودانی پیچ سرگرد 12×5M + مهرٔه نایلوندار + واشر 985 DIN / 7380 ISO، استیل 2A ۱۶ ۴ نیوتنمتر درپوش سر بازو پرچ پاپ ۸ × ۴Ø آلومینیومی ۳۲ — سرپیچ روی درپوش پیچ 4M + مهرٔه نایلوندار )طبق سوراخ سرپیچ( استیل 2A ۱۶ ۱٫۵ نیوتنمتر

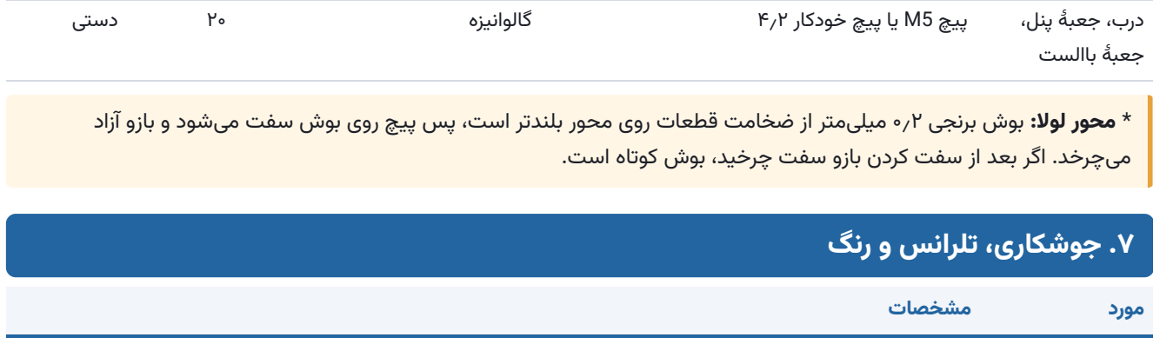
[picture p21: figure]
درب، جعبٔه پنل،; جعبٔه باالست; .۷ جوشکاری، تلرانس و رنگ; مورد مشخصات

پیچ 5M یا پیچ خودکار ۴٫۲ گالوانیزه ۲۰ دستی

* محور لوال: بوش برنجی ۰٫۲ میلیمتر از ضخامت قطعات روی محور بلندتر است، پس پیچ روی بوش سفت میشود و بازو آزاد میچرخد. اگر بعد از سفت کردن بازو سفت چرخید، بوش کوتاه است.

روش جوش (2CO (MAG، سیم ۰٫۸Ø؛ ورق ۱٫۵ با جریان کم یا جوش نقطهای ستون به فلنج گوشهای 3a دور تا دور لچکیها گوشهای 3a دو طرف، روی فلنج و ستون درز ستون )دو U )جوش نقطهای هر ۵۰ یا پرچ ۴Ø هر ۸۰ درپوش ستون گوشهای 2a دور تا دور دیسک به براکت گوشهای 3a دور کف براکت؛ اول با میلٔه ۱۴Ø هممحور کنید، چهار نقطه خال بزنید، بعد جوش کامل مهرٔه جوشی 12M سه نقطه یا دور تا دور؛ پیش از جوش با پین هممحور کنید؛ پاشش جوش داخل رزوه نرود تلرانس عمومی m2768- ISO؛ ستون عمود بر فلنج ۱± در ۱۰۰۰؛ دو صفحٔه سر موازی ۱± آمادهسازی رنگ چربیگیری و فسفاته یا سندبالست رنگ پودری پلیاستر، ضخامت ۶۰–۸۰ میکرون، 9016 RAL( سفید( یا 7035 RAL( طوسی روشن( ماسک قبل از رنگ رزؤه مهرههای 12M، پرچمهرهها، سوراخهای ۱۴Ø و ۱۳ سوراخ دیسک، و یک نقطٔه ارت روی ستون، پایه و هر براکت آلومینیوم بدون رنگ؛ محافظ نایلونی تا مونتاژ نهایی بماند

چرخش بازوها روان و بدون لقی محوری؛ قفل در هر ۱۳ موقعیت؛ لقی نوک بازو در حالت قفل ≥ ۳± فاصلٔه بازوی پارک نوک بازو حداقل ۵۰ باالی جعبٔه باالست پایداری دو بازوی یک طرف افقی، هل مالیم از باال: دستگاه واژگون نمیشود پیوستگی ارت مقاومت بین پین ارت دوشاخه و هر بازو، ستون و پایه ≥ ۰٫۱ اهم مقاومت عایقی با میگر ۵۰۰ ولت DC بین فاز/نول و بدنه ≤ ۲ مگااهم تأخیر شروع المپها ۳۰ تا ۶۰ ثانیه بعد از روشن کردن کلید روشن میشوند

قطع با PIR خاموش میشوند و خودبهخود روشن نمیشوند

با حرکت جلوی سنسور، المپها فورًا
استاپ اضطراری قطع میشود

با فشار، همه چیز فورًا
ساعتشمار و چراغ هشدار فقط وقتی المپها روشناند کار میکنند شدت تابش با C-UV متر یا کارت اندیکاتور در فاصلٔه ۱ متر اندازه بگیرید و زمان الزم برای دوز هدف را ثبت کنید

ایمنی: C-UV در چند ثانیه به پوست و چشم آسیب میزند. در همٔه تستهای روشن، عینک و دستکش ضد UV بپوشید و کسی جلوی
