Houman1368/Waste/uvc-arm-stand/docs/UV-C_stand_shopping_and_production_list.pdf

لیست خرید و برنامه تولید — دو مرحلهای

پایه C-UV چهاربازو ۳۰ وات · طرح نهایی · ۱۸ مهر ۱۴۰۵ · همٔه ابعاد به میلیمتر

مرحلٔه ۱ )از فردا(: خرید قطعات + ساخت ستون و پایه + یک نمونٔه کامل از صفحٔه سر با دو بازو و تست آن

۱ لوازم برقی ۲ چرخ و یراق ۳ پیچ و مهره ۴ برش لیزر و خم — مرحلٔه ۱ ۵ جوش — مرحلٔه ۱ ۶ تست نمونه ✔ مرحلٔه ۲ )فقط بعد از قبول شدن تست نمونه(: بقیٔه قطعات + رنگ پودری همه با هم

### ۷ برش لیزر و خم — مرحلٔه ۲ ۸ جوش — مرحلٔه ۲ ۹ رنگ پودری ۱۰ مونتاژ نهایی

چرا دو مرحله؟ چند عدد هنوز حدسی است: ارتفاع چرخ، فاصلٔه سرپیچها، ابعاد پین فنری و ضریب خم کارگاه. با ساختن یک نمونه، اگر چیزی جور درنیامد، فقط یک صفحٔه سر، دو دیسک، دو براکت و دو بازو هدر میرود، نه کل دستگاه. ستون و پایه به این عددها بستگی ندارند و از همان اول ساخته میشوند.

چرا اول لوازم برقی و چرخ؟ المپ، سرپیچ و چرخ باید قبل از برش لیزر خریده و اندازهگیری شوند. اگر فاصلٔه دو سرپیچ با المپ واقعی ۹۰۸ نبود یا ارتفاع چرخ ۱۰۰ نبود، قبل از رفتن به برش لیزر خبر بدهید تا فایلها اصالح شوند.

با خودتان ببرید:
فلش حاوی پوشههای /dxf( برای لیزر( و /step( مدل سهبعدی برای کارگاه( همین PDF چاپشده و تصاویر صفحٔه آخر برای نشان دادن به کارگاه متر و کولیس برای اندازهگیری المپ، سرپیچ و چرخ در محل

آدرس مغازٔه مشخصی در این لیست نیامده است. برای هر ایستگاه نوع مغازه نوشته شده. با جستجوی همان عنوان در نقشه یا دیوار، نزدیکترین را پیدا کنید و قبل از رفتن تماس بگیرید. بیشتر برشلیزرها خمکاری هم دارند و ورق را هم خودشان تهیه

یکی میشوند.

میکنند؛ این یعنی ایستگاه ۴ و ۵ معمو ًال

## ۱ لوازم برقی و روشنایی مرحلٔه ۱

جایی که بروید: فروشگاه لوازم برق صنعتی / روشنایی، یا فروشندٔه المپ C-UV و تجهیزات ضدعفونی

قلم مشخصات تعداد قیمت
المپ C-UV ۳۰ 8،T وات، ۲۵۳٫۷ نانومتر، پایه 13G، طول حدود ۸۹۵ با پین ۴ )۱+ یدک( سرپیچ 13G فنری سرامیکی یا فلزی، مقاوم UV؛ پالستیک معمولی نه ۸ باالست الکترونیک مخصوص المپ 8T سیوات C-UV( یا ۲ عدد دوبل ۲×۳۰( ۴ تایمر دیجیتال با تأخیر شروع قابل تنظیم ۳۰ تا ۶۰ ثانیه، ریلی یا پنلی ۱ سنسور حرکت PIR زاویٔه دید ≤،°۱۱۰ خروجی رله ۱ تا ۲ رله یا کنتاکتور بوبین ۲۲۰ ولت، برای قطع با PIR( روشن شدن دوباره فقط دستی(

۱

کلید سوئیچی )قفلدار( دو حالته، کلید از دستگاه جدا شود ۱ شستی استاپ اضطراری قارچی قرمز، کنتاکت NC ۱

ساعتشمار کارکرد ۲۲۰ ولت، پنلی ۱
چراغ هشدار »UV روشن« ۲۲۰ ،LED ولت، رنگ قرمز یا بنفش ۱ فیوز + جافیوزی ۲ آمپر ۱
کابل سیلیکونی یا تفلونی ۴×،۰٫۷۵ مقاوم UV و حرارت )PVC معمولی ممنوع( ۸ متر کابل برق ورودی + دوشاخه ارتدار +

گلند

۳×،۱ طول ۳ متر ۱

ترمینال ریلی + ریل امگا برای جعبٔه باالست ۱۲ عدد سیم ارت زرد-سبز + سرسیم ۱٫۵ میلیمتر، برای ستون، پایه و هر بازو ۳ متر برچسب هشدار C-UV روی هر بازو و روی پنل ۵

در همین مغازه اندازه بگیرید: المپ را داخل دو سرپیچ بگذارید و فاصلٔه داخلی دو سرپیچ را بخوانید )باید حدود ۹۰۸ باشد(. عمق هر سرپیچ را هم بنویسید )حدود ۲۰(. اگر فرق داشت، قبل از برش آلومینیوم خبر بدهید.

## ۲ چرخ و یراق صنعتی مرحلٔه ۱

جایی که بروید: فروشگاه چرخ صنعتی، و فروشگاه یراقآالت صنعتی / لوازم قالبسازی )برای پین فنری(

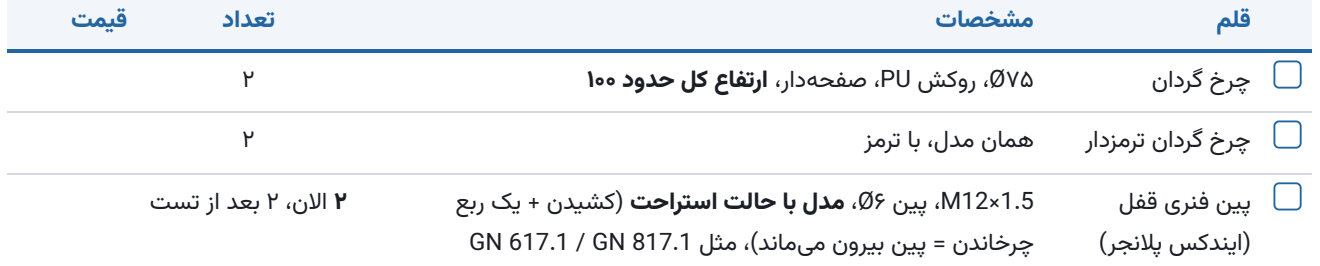
[picture p22: figure]
قلم مشخصات تعداد قیمت; چرخ گردان ترمزدار همان مدل، با ترمز ۲; پین فنری قفل; )ایندکس پالنجر(; ۲ االن، ۲ بعد از تست

چرخ گردان ۷۵Ø، روکش PU، صفحهدار، ارتفاع کل حدود ۱۰۰ ۲

1.5×12M، پین ۶Ø، مدل با حالت استراحت )کشیدن + یک ربع چرخاندن = پین بیرون میماند(، مثل 817.1 GN / 617.1 GN بوش برنجی داخل ۱۰Ø، بیرون ۱۴Ø، طول ۱۰٫۲ )اگر آماده نبود، تراشکار میسازد( ۴ واشر تفلونی ۱ × ۱۴Ø / ۳۰Ø( یا ورق تفلون ۱ میلی برای بریدن( ۴ گرومت الستیکی برای سوراخ ۱۶Ø ورق ۱٫۵ ۲ گرومت فلزی / گلند برای سوراخ ۱۰Ø ورق آلومینیوم ۴ لوله استیل یا آهنی ۲۵Ø، برای دستٔه هلدادن )۳۰۰ + ۲ پایه ۵۰( ۰٫۵ متر مفتول استیل ۳Ø، برای ۴ گارد المپ ۵۰×۹۲۰ )+ گیره( ۱۰ متر

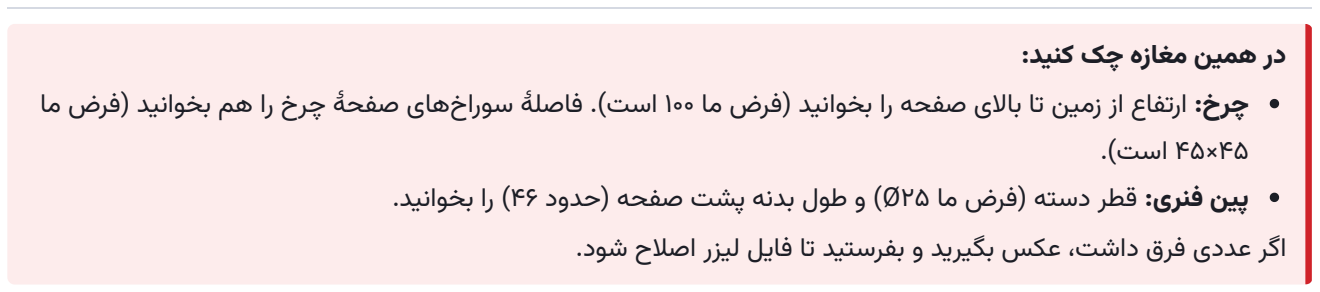
[picture p23: figure]
در همین مغازه چک کنید:; ۴۵×۴۵ است(.

چرخ: ارتفاع از زمین تا باالی صفحه را بخوانید )فرض ما ۱۰۰ است(. فاصلٔه سوراخهای صفحٔه چرخ را هم بخوانید )فرض ما

پین فنری: قطر دسته )فرض ما ۲۵Ø )و طول بدنه پشت صفحه )حدود ۴۶( را بخوانید. اگر عددی فرق داشت، عکس بگیرید و بفرستید تا فایل لیزر اصالح شود.

## ۳ پیچ و مهره مرحلٔه ۱

جایی که بروید: فروشگاه پیچ و مهره و ابزار )پرچمهره و انبر پرچمهره را هم همینجا بپرسید( قلم مشخصات تعداد کاربرد
پیچ سرگرد آلن 30×10M 7380 ISO، گرید ۸٫۸ ۴ محور لوال )سر داخل ناودانی( مهرٔه نایلوندار 10M + واشر تخت 985 DIN ۴ + ۸ پشت صفحٔه سر، روی محور مهرٔه جوشی 1.5×12M ششگوش، رزوه ریز ۴ پشت صفحٔه سر برای پین فنری پیچ خزینه آلن 12×8M گرید ۸٫۸ ۱۲ صفحههای سر به ستون پرچمهره 8M( ریوتناتی( برای ورق ۱٫۵ ۱۲ )۴+( روی ستون؛ انبر پرچمهره هم الزم است پیچ سرگرد 12×5M + مهرٔه نایلوندار استیل ۱۶ براکت بازو به دیوارٔه ناودانی پیچ 30×10M + مهره + ۲ واشر گرید ۸٫۸ ۴ فلنج ستون به صفحٔه پایه پیچ 20×8M + مهرٔه نایلوندار + واشر یا طبق سوراخ صفحٔه چرخ ۱۶ چرخها پرچ پاپ / پیچ پرچ 4M آلومینیومی ۳۲ درپوش سر بازو پیچ سرخزینه 4M + مهره طبق سرپیچ 13G ۱۶ سرپیچها روی درپوش پیچ خودکار 4M یا پیچ پرچ — ۲۰ درب سرویس، جعبٔه پنل، جعبٔه باالست واشر دندانهدار 10M برای اتصال ارت از طریق محور ۴ ارت بازوها

## ۴ برش لیزر و خم مرحلٔه ۱

بر اساس

جایی که بروید: کارگاه برش لیزر ورق فلزی که خمکاری )پرسبرک( هم دارد. بپرسید ورق را خودشان تهیه میکنند یا نه؛ معمو ًال کیلو حساب میکنند. ستون »مرحلٔه ۱« را االن سفارش دهید. ستون »مرحلٔه ۲« را فقط به کارگاه بگویید که بعدًا میآیید، تا اگر الزم شد

فایل DXF قطعه ورق مرحلٔه ۱ مرحلٔه ۲ نکته برای کارگاه mm6_plate_base_1B صفحٔه پایه ۵۰۰×۴۰۰ فوالد ۶ ۱ — سوراخهای چرخ را با چرخ واقعی چک

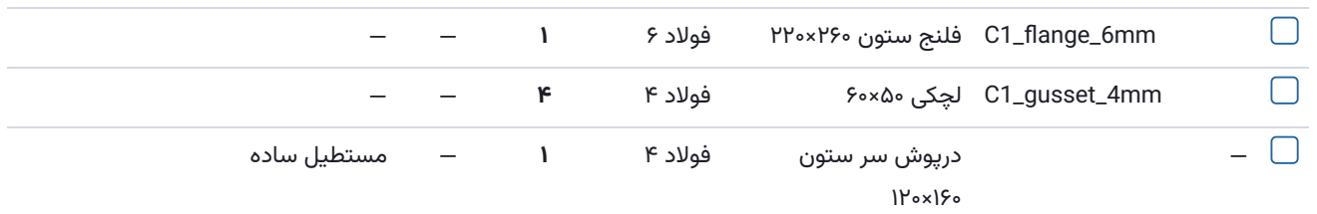
[picture p24: figure]
۴ فوالد; لچکی; C1_gusset_4mm; — درپوش سر ستون ۱۲۰×۱۶۰; فوالد ۴ ۱ — مستطیل ساده

mm6_flange_1C فلنج ستون ۲۶۰×۲۲۰ فوالد ۶ ۱ — —

— بدنٔه ستون، دو تکه U +

خم

فوالد ۱٫۵ ۲ — هر تکه حدود ۲۸۰×۱۰۵۰ گسترده: کف
۱۶۰ + دو لبٔه ۶۰؛ روی هم باکس ۱۶۰×۱۲۰
میسازند
— جعبٔه باالست 2B + خم فوالد ۱٫۵ ۱ — بالنک حدود ۶۲۰×۵۲۰ )سقف ۴۶۰×۳۶۰ + دیوارٔه ۸۰( با سوراخ ستون ۱۷۰×۱۳۰

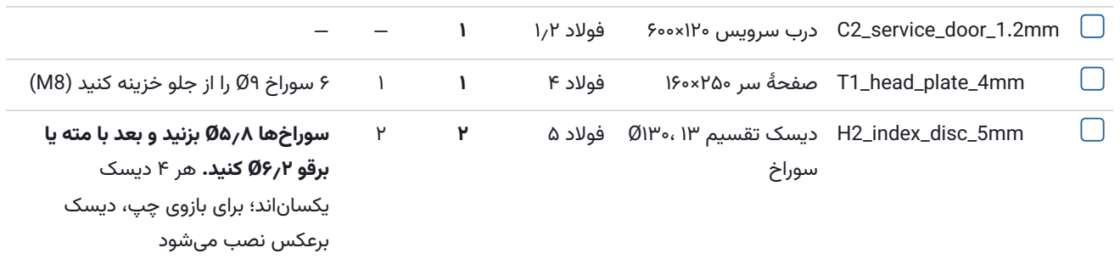
[picture p25: figure]
۱٫۲ فوالد; سرویس; درب C2_service_door_1.2mm; تقسیم; دیسک; H2_index_disc_5mm; سوراخ; برقو ۶٫۲Ø کنید. هر ۴ دیسک یکساناند؛ برای بازوی چپ، دیسک; برعکس نصب میشود

mm4_plate_head_1T صفحٔه سر ۲۵۰×۱۶۰ فوالد ۴ ۱ ۱ ۶ سوراخ ۹Ø را از جلو خزینه کنید )8M) فوالد ۵ ۲ ۲ سوراخها ۵٫۸Ø بزنید و بعد با مته یا

کف )خم | + بازو U | براکت | H1_bracket_blank_4mm
داخلی ،۶۰ ساق ۲۶(

فوالد ۴ ۲ ۲ طول گسترده را با ضریب خم خودتان

چک کنید
mm1_blank_arm_1A بدنٔه بازو ۹۵۰×۱۷۰ + خم ناودانی ۱۰/۴۵/۶۰/۴۵/۱۰

آلومینیوم ۱
آینهای

۲ ۲ فقط بعد از اندازه گرفتن المپ و سرپیچ ببرید. رویٔه براق داخل ناودانی باشد؛

محافظ نایلونی را تا آخر نکنید
چهار + بازو سر | درپوش | A2_end_cap_blank_1mm

لبٔه ۱۰

آلومینیوم ۱ ۴ ۴ —

— جعبٔه پنل کنترل
۶۰×۱۱۰×۱۸۰ + خم

فوالد ۱٫۲ — ۱ بعد از اینکه تایمر و کلیدها را دارید؛ اول

چک کنید عمق ۶۰ برایشان کافی است
مقدار تقریبی ورق کل کار )برای پرسیدن قیمت( ورق قطعات وزن تقریبی خالص
فوالد 37ST ضخامت ۶ صفحٔه پایه + فلنج حدود ۱۲ کیلو فوالد 37ST ضخامت ۵ ۴ دیسک تقسیم حدود ۳ کیلو

فوالد 37ST ضخامت ۴ صفحههای سر، براکتها، لچکیها، درپوش ستون حدود ۴٫۵ کیلو ورق روغنی ۱٫۵ ستون + جعبٔه باالست حدود ۱۱ کیلو ورق روغنی ۱٫۲ درب سرویس + جعبٔه پنل حدود ۱٫۵ کیلو آلومینیوم ۱ آینهای ۴ بازو + ۸ درپوش یک ورق ۱۰۰۰×۱۰۰۰ کافی است؛ اگر

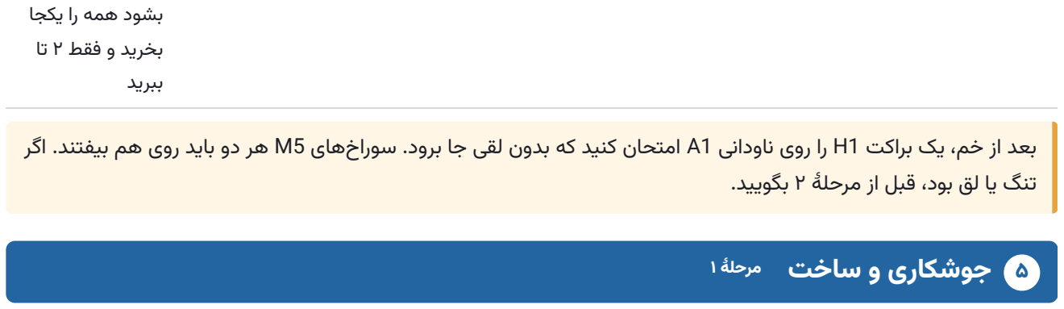
[picture p26: figure]
بشود همه را یکجا بخرید و فقط ۲ تا; ببرید; تنگ یا لق بود، قبل از مرحلٔه ۲ بگویید.; ۵ جوشکاری و ساخت مرحلٔه ۱

بعد از خم، یک براکت 1H را روی ناودانی 1A امتحان کنید که بدون لقی جا برود. سوراخهای 5M هر دو باید روی هم بیفتند. اگر

جایی که بروید: کارگاه جوشکاری و ساخت قطعات فلزی )فابریکیشن(. هنوز رنگ نکنید.

دو U ستون را به هم جوش نقطهای یا پرچ کنید → باکس ۱۶۰×۱۲۰×۱۰۵۰ وجههای ۱۶۰ جلو و پشتاند درپوش ۴ میلی را باالی ستون جوش دهید — وسط فلنج جوش دهید + ۴ لچکی وسط هر وجه

ستون را دقیقًا ستون کام ًال عمود باشد )با گونیا( | ًا
صفحٔه سر را روی وجه جلو بگذارید )۲۸ باالتر از سر ستون( و ۶ سوراخ پیچ را از روی آن عالمت بزنید. همین را برای وجه پشت هم عالمت بزنید

سوراخ ۱۰Ø برای پرچمهرٔه 8M؛ ۲ سوراخ ۱۶Ø
کابل ۲۵ زیر صفحٔه سر، ۴۵ از وسط
درب سرویس روی وجه پشت: بازشو ۱۰۰×۵۸۰ از ارتفاع ۳۱۰ ببرید درب ۱۲۰×۶۰۰ با ۴ پیچ دستٔه هلدادن: لوله ۲۵Ø با دو پایٔه ،۵۰ روی وجه راست ستون باالی دسته در ارتفاع ۱۰۰۰ از زمین )با چرخ( نمونه: مهرٔه جوشی 1.5×12M را پشت صفحٔه سِر مرحلٔه ،۱ روی دو سوراخ پین

جوش دهید

عمود و هممحور؛ قبل از جوش پین را بچرخانید
و ببینید از سوراخ رد میشود نمونه: دو دیسک را وسط کف دو براکت جوش دهید هممحور؛ با یک میلٔه

سوراخ ۱۴Ø هر دو دقیقًا
۱۴Ø نگه دارید و جوش دهید
بوش برنجی )اگر آماده نبود(: ۱۴Ø۱۰/Ø طول ۱۰٫۲ تراشکاری؛ ۲ عدد برای نمونه

## ۶ تست نمونه — قبل از مرحلٔه ۲

چرخها را زیر پایه، ستون را روی پایه و جعبٔه باالست را سر جایش ببندید. صفحٔه سر نمونه را روی ستون ببندید و دو بازو را با المپ رویش سوار کنید. همه باید تیک بخورد.

براکت روی ناودانی بدون لقی جا میرود، ۴ پیچ 5M راحت رد میشوند چرخش بازو روی محور روان است و لقی محوری ندارد )مهرٔه نایلوندار را تنظیم کنید(

قفل ۱۳ موقعیت )،۰ ،۱۵ ...، ۱۸۰( پین در همه کامل جا میافتد؛ حالت استراحت پین کار میکند دسترسی به دستٔه پین و مهرٔه محور از کنار ستون با دست و آچار ۱۷ راحت میرسد لقی سر بازو در حالت قفل کمتر از حدود ۵ میلیمتر در نوک بازو دو بازو هر دو افقی )°۹۰( به هم نمیخورند بازو پارک )°۰( نوک بازو حداقل ۵۰ باالی جعبٔه باالست )طرح: ۵۴( ارتفاع محور لوال از زمین حدود ۱۱۵۰ المپ در سرپیچها راحت جا میرود و محکم است؛ سر پیچ محور به المپ نمیخورد پایداری با دو بازوی یک طرف افقی، هل مالیم از باال دستگاه را نمیاندازد

از نمونه عکس بگیرید و عددها را بفرستید. اگر همه درست بود، مرحلٔه ۲ را سفارش دهید. اگر چیزی جور درنیامد، فایلها اصالح میشوند و فقط قطعههای نمونه دوباره بریده میشوند.

## ۷ برش لیزر و خم مرحلٔه ۲

همان کارگاه مرحلٔه .۱ ستون »مرحلٔه ۲« جدول باال )ایستگاه ۴( را سفارش دهید، با اصالحاتی که بعد از تست نمونه الزم شد:

قطعه تعداد
صفحٔه سر 1T( وجه پشت( ۱
دیسک تقسیم 2H( با برقو( ۲
براکت 1H + خم ۲
بدنٔه بازو 1A + خم ۲
درپوش سر بازو 2A + خم ۴

جعبٔه پنل کنترل 3C + خم ۱

در همین مرحله ۲ پین فنری باقیمانده را بخرید )و ۱ یدک(.

مهرٔه جوشی 1.5×12M پشت صفحٔه سر دوم مثل نمونه دو دیسک را روی دو براکت جوش دهید با میلٔه ۱۴Ø هممحور جعبٔه پنل روی وجه چپ ستون، لبٔه باال ۹۹۰ از

سوراخهای تایمر، کلید، استاپ، ساعتشمار و چراغ را از روی قطعات خریدهشده

گارد مفتولی ۴ عدد ۵۰×۹۲۰ از مفتول ۳Ø با گیره روی لبههای ناودانی کلیپس شود بوش برنجی )طول ۱۰٫۲( ۲ عدد دیگر )اگر آماده

## ۹ رنگ پودری — همه با هم مرحلٔه ۲

جایی که بروید: کارگاه رنگ الکترواستاتیک )پودری(. قطعات نمونه را هم باز کنید و با بقیه رنگ کنید.

ستون با فلنج، صفحٔه پایه، جعبٔه باالست، درب سرویس، جعبٔه پنل، دسته، ۲ صفحٔه سر، ۴ براکت

ماسک کردن قبل از رنگ: رزؤه مهرههای جوشی 12M، پرچمهرهها، سوراخهای ۱۴Ø دیسک و

رنگ در سوراخها پین و بوش را گیر

یک نقطٔه بدون رنگ برای پیچ ارت روی ستون، پایه و هر براکت ارت الزامی است بازوهای آلومینیومی رنگ نمیشوند )داخلشان رفلکتور است( —

## تصاویر برای نشان دادن به کارگاه

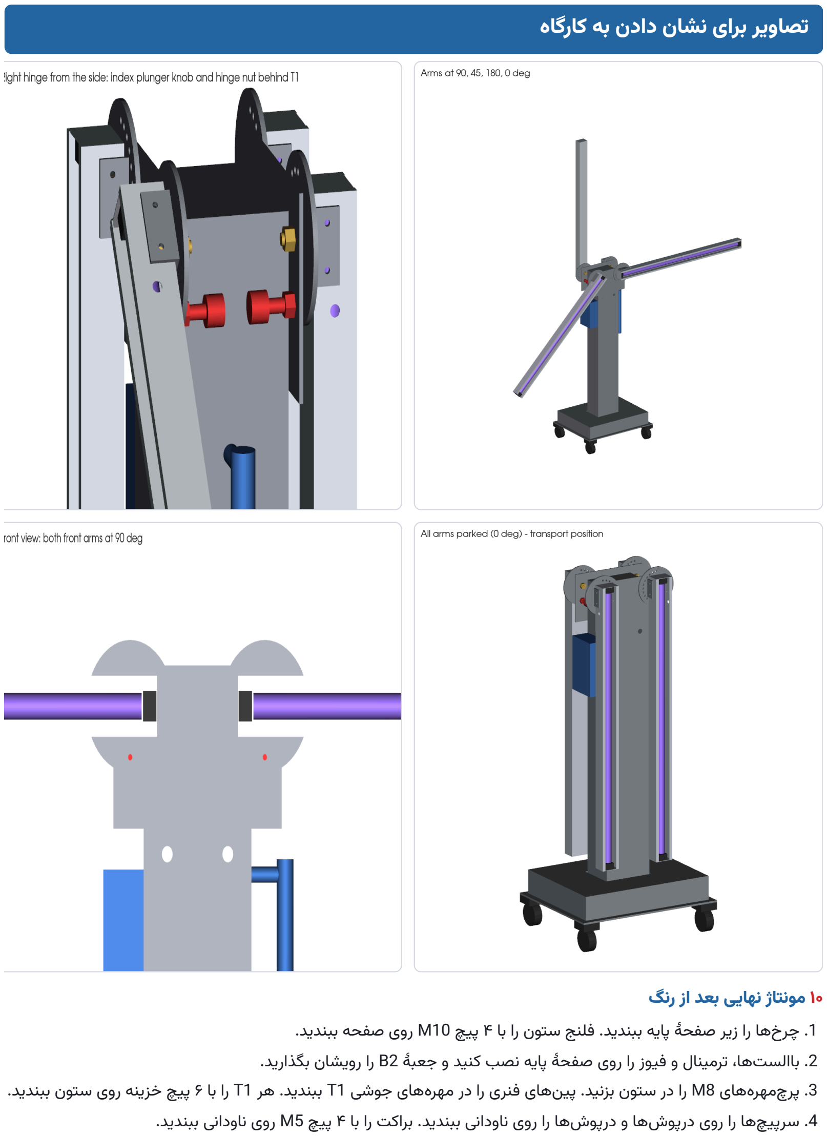
[picture p27: page 8]

### ۱۰ مونتاژ نهایی بعد از رنگ

.1 چرخها را زیر صفحٔه پایه ببندید. فلنج ستون را با ۴ پیچ 10M روی صفحه ببندید. .2 باالستها، ترمینال و فیوز را روی صفحٔه پایه نصب کنید و جعبٔه 2B را رویشان بگذارید. .3 پرچمهرههای 8M را در ستون بزنید. پینهای فنری را در مهرههای جوشی 1T ببندید. هر 1T را با ۶ پیچ خزینه روی ستون ببندید. .4 سرپیچها را روی درپوشها و درپوشها را روی ناودانی ببندید. براکت را با ۴ پیچ 5M روی ناودانی ببندید.

.5 بازو را روی 1T سوار کنید: پیچ 30×10M از داخل ناودانی، بعد بوش برنجی، دیسک، واشر تفلونی و 1T، و پشتش مهرٔه نایلوندار. فقط آنقدر سفت کنید که بازو روان بچرخد ولی لق نباشد. .6 قفل هر ۱۳ موقعیت را با پین امتحان کنید. بازو در ۰ درجه باید حدود ۵۰ میلیمتر باالی جعبٔه باالست باشد. .7 سیمکشی، ارت و تست عایقی را انجام دهید. بعد تأخیر شروع، قطع با PIR و استاپ اضطراری را تست کنید. .8 المپها و گاردها را نصب کنید. تست پایداری را انجام دهید و شدت تابش را در فاصلٔه ۱ متر اندازه بگیرید.

ایمنی: C-UV در چند ثانیه به پوست و چشم آسیب میزند. هنگام تست، عینک و دستکش ضد UV بپوشید. دستگاه فقط در اتاق خالی روشن شود. قفل PIR و تأخیر شروع نباید قابل حذف باشند.
