Houman1368/Waste/uvc-arm-stand/step/UVC_stand_assembly.step

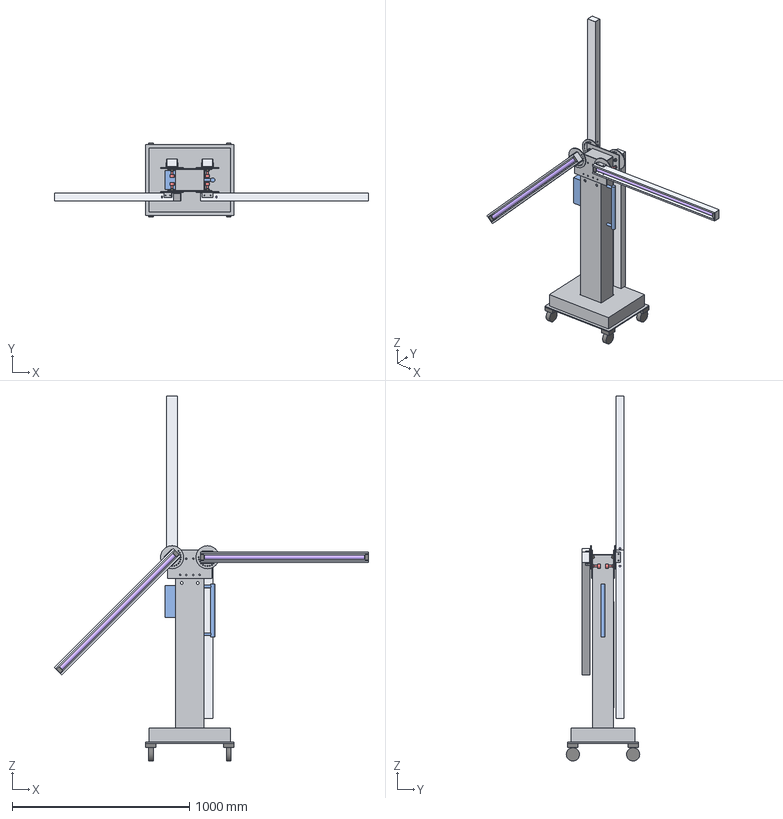
[picture p28: CAD file, 2026-10-09]
uvc-arm-stand/step/UVC_stand_assembly.step
1774.7 x 415.0 x 2059.9 mm
B1_base_plate
B2_ballast_box
C1_column
C1_top_cap
C1_flange
C2_service_door
C3_panel_box
handle
T1_head_plate_front
T1_head_plate_back
T1_screws_front
T1_screws_back
C1_gusset_1
C1_gusset_2
C1_gusset_3
C1_gusset_4
B3_caster_1
B3_caster_2
B3_caster_3
B3_caster_4
FR_channel
FR_caps
FR_sockets
FR_lamp
FR_bracket
FR_disc
FR_bolt_head
FR_plunger
FR_hinge_fixed
FL_channel
FL_caps
FL_sockets
FL_lamp
FL_bracket
FL_disc
FL_bolt_head
FL_plunger
FL_hinge_fixed
BR_channel
BR_caps
BR_sockets
BR_lamp
BR_bracket
BR_disc
BR_bolt_head
BR_plunger
BR_hinge_fixed
BL_channel
BL_caps
BL_sockets
BL_lamp
BL_bracket
BL_disc
BL_bolt_head
BL_plunger
BL_hinge_fixed
