Houman1368/Waste/uvc-arm-stand/dxf/C1_gusset_4mm_x4.dxf

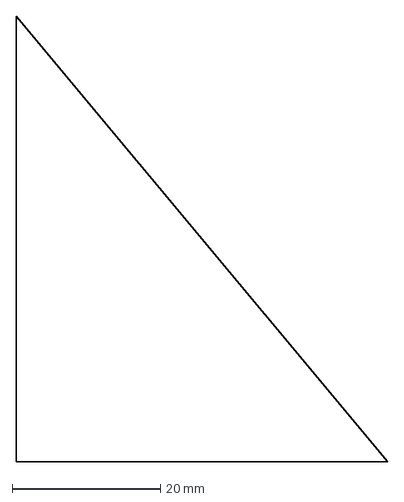
[picture p29: CAD file, 2026-10-09]
uvc-arm-stand/dxf/C1_gusset_4mm_x4.dxf
50.0 x 60.0 mm
