Houman1368/Waste/uvc-arm-stand/step/parts/H4_index_plunger_envelope.step

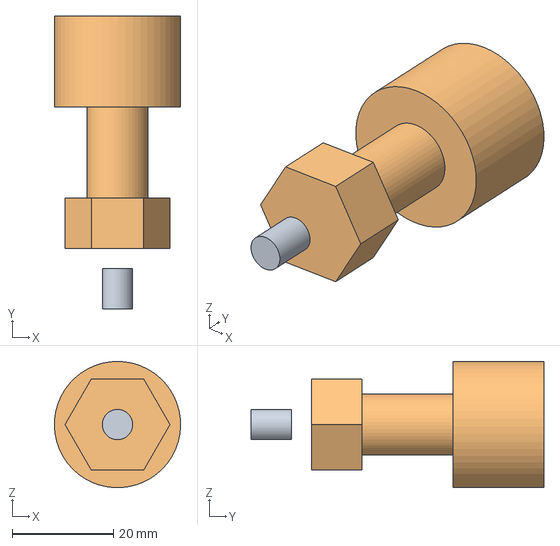
[picture p30: CAD file, 2026-10-09]
uvc-arm-stand/step/parts/H4_index_plunger_envelope.step
25.0 x 58.0 x 25.0 mm
