Houman1368/Waste/uvc-arm-stand/dxf/A2_end_cap_blank_1mm_x8.dxf

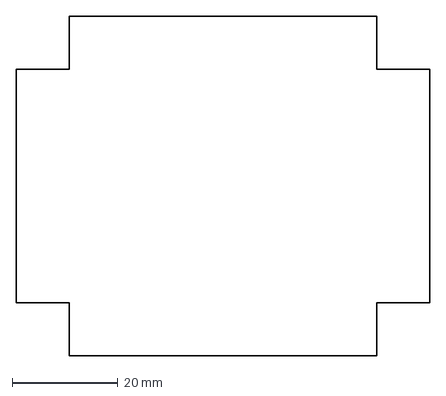
[picture p31: CAD file, 2026-10-09]
uvc-arm-stand/dxf/A2_end_cap_blank_1mm_x8.dxf
78.0 x 64.0 mm
