Houman1368/Waste/uvc-arm-stand/step/parts/A1_arm_channel.step

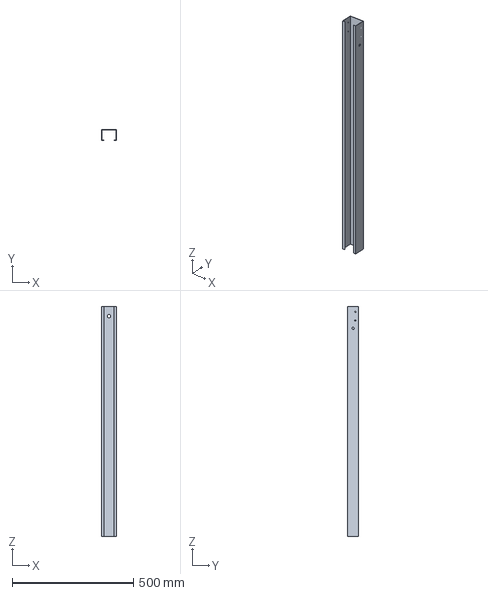
[picture p32: CAD file, 2026-10-09]
uvc-arm-stand/step/parts/A1_arm_channel.step
60.0 x 45.0 x 950.0 mm
