Houman1368/Waste/uvc-arm-stand/dxf/T1_head_plate_4mm_x2.dxf

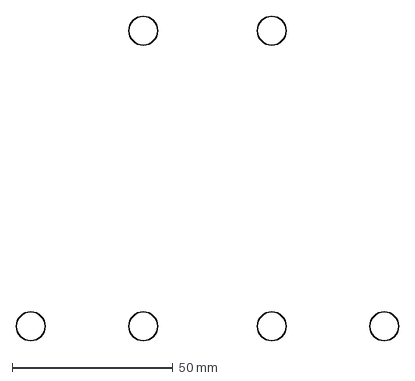
[picture p33: CAD file, 2026-10-09]
uvc-arm-stand/dxf/T1_head_plate_4mm_x2.dxf
119.0 x 101.0 mm
