Houman1368/Waste/uvc-arm-stand/step/parts/B1_base_plate.step

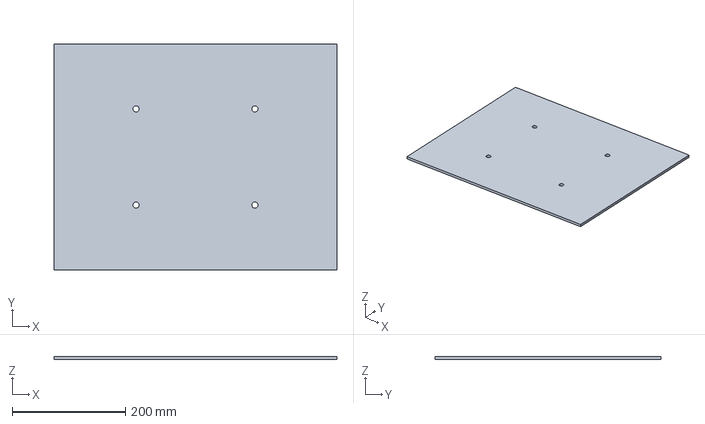
[picture p34: CAD file, 2026-10-09]
uvc-arm-stand/step/parts/B1_base_plate.step
500.0 x 400.0 x 6.00 mm
