Houman1368/Waste/uvc-arm-stand/dxf/H1_bracket_blank_4mm_x4.dxf

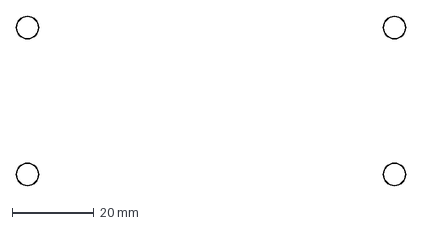
[picture p35: CAD file, 2026-10-09]
uvc-arm-stand/dxf/H1_bracket_blank_4mm_x4.dxf
95.5 x 41.5 mm
