Houman1368/Waste/uvc-arm-stand/step/parts/C1_top_cap.step

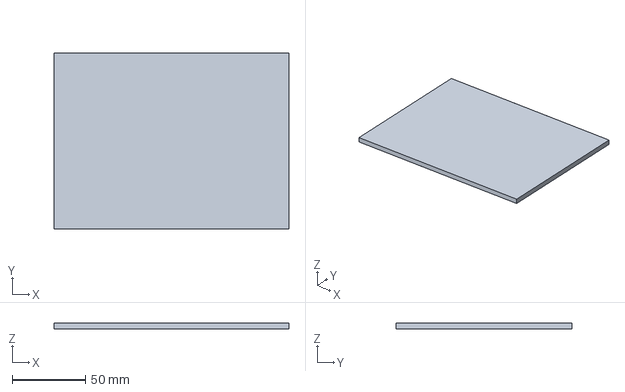
[picture p36: CAD file, 2026-10-09]
uvc-arm-stand/step/parts/C1_top_cap.step
160.0 x 120.0 x 4.00 mm
