Houman1368/Waste/uvc-arm-stand/dxf/B1_base_plate_6mm.dxf

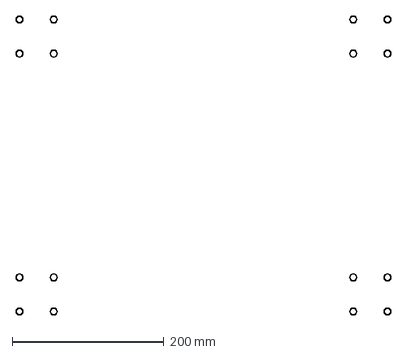
[picture p37: CAD file, 2026-10-09]
uvc-arm-stand/dxf/B1_base_plate_6mm.dxf
494.0 x 394.0 mm
