Houman1368/Waste/uvc-arm-stand/step/parts/B2_ballast_box.step

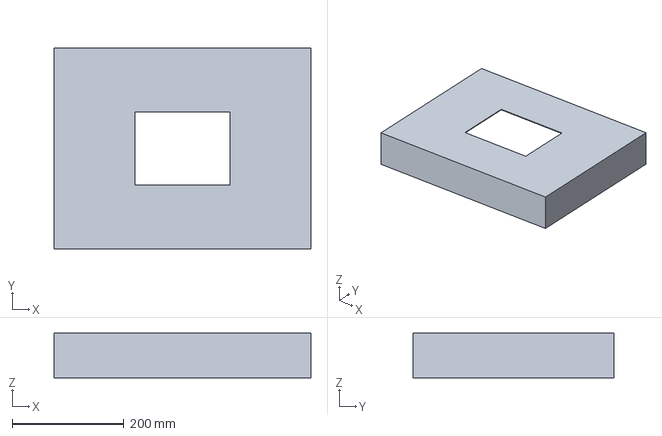
[picture p38: CAD file, 2026-10-09]
uvc-arm-stand/step/parts/B2_ballast_box.step
460.0 x 360.0 x 80.0 mm
