Houman1368/Waste/uvc-arm-stand/dxf/C2_service_door_1.2mm.dxf

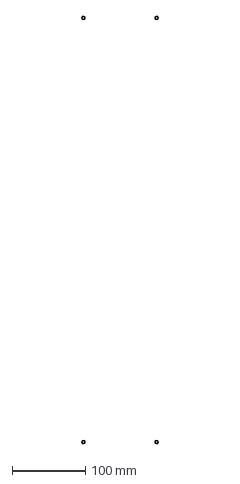
[picture p39: CAD file, 2026-10-09]
uvc-arm-stand/dxf/C2_service_door_1.2mm.dxf
104.2 x 584.2 mm
