Houman1368/Waste/uvc-arm-stand/step/parts/H2_index_disc.step

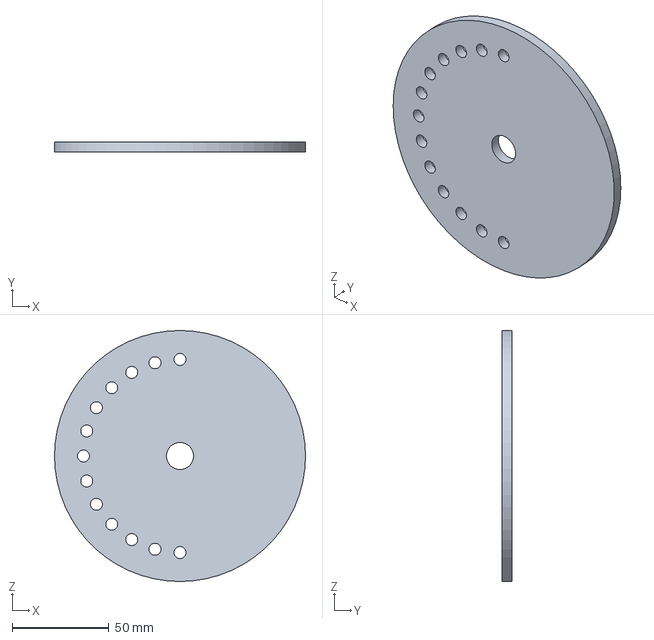
[picture p40: CAD file, 2026-10-09]
uvc-arm-stand/step/parts/H2_index_disc.step
130.0 x 5.00 x 130.0 mm
