Houman1368/Waste/uvc-arm-stand/dxf/A1_arm_blank_1mm_x4.dxf

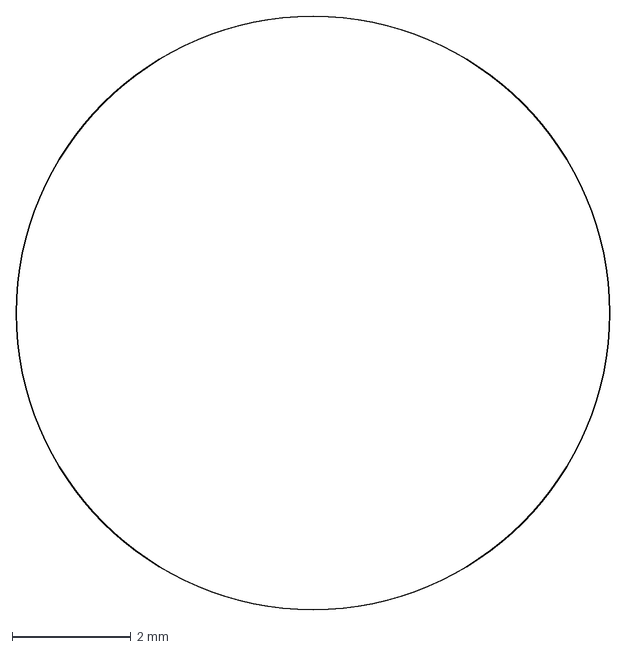
[picture p41: CAD file, 2026-10-09]
uvc-arm-stand/dxf/A1_arm_blank_1mm_x4.dxf
10.0 x 10.0 mm
