Houman1368/Waste/uvc-arm-stand/step/parts/push_handle.step

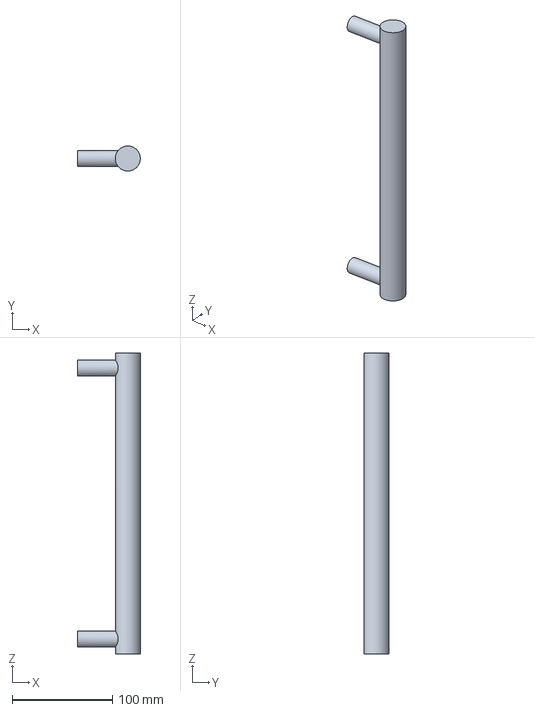
[picture p42: CAD file, 2026-10-09]
uvc-arm-stand/step/parts/push_handle.step
62.5 x 25.0 x 300.0 mm
