Houman1368/Waste/uvc-arm-stand/dxf/H2_index_disc_5mm_x4_(mirror_2).dxf

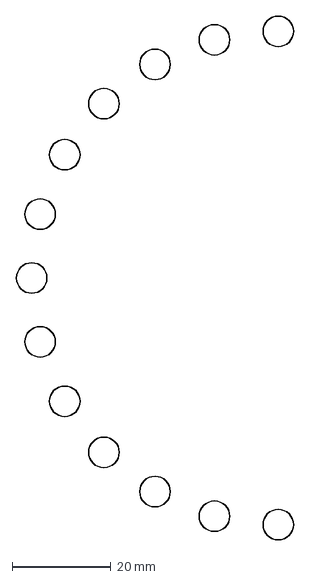
[picture p43: CAD file, 2026-10-09]
uvc-arm-stand/dxf/H2_index_disc_5mm_x4_(mirror_2).dxf
56.2 x 106.2 mm
