Houman1368/Waste/uvc-arm-stand/step/parts/C2_service_door.step

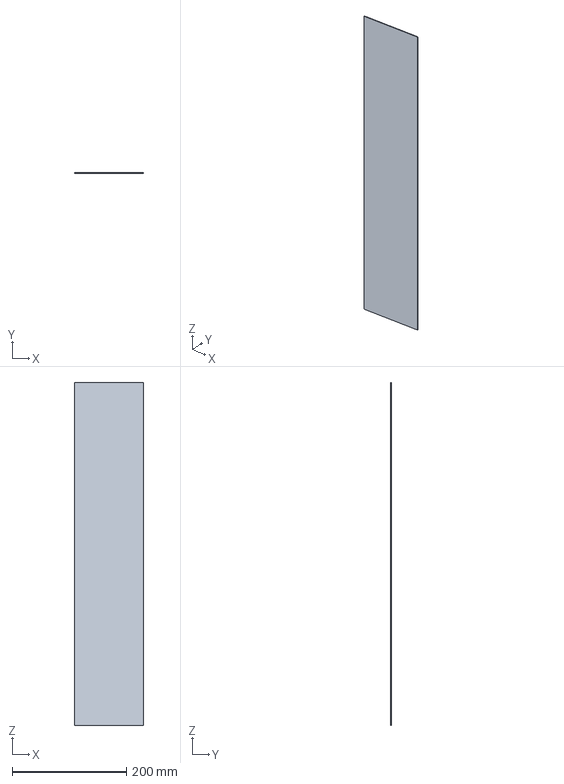
[picture p44: CAD file, 2026-10-09]
uvc-arm-stand/step/parts/C2_service_door.step
120.0 x 1.20 x 600.0 mm
