Houman1368/Waste/uvc-arm-stand/dxf/C1_flange_6mm.dxf

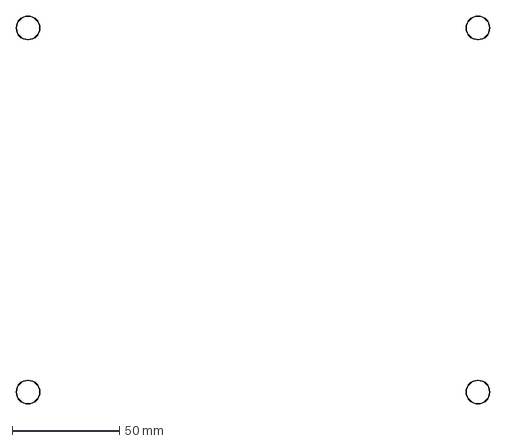
[picture p45: CAD file, 2026-10-09]
uvc-arm-stand/dxf/C1_flange_6mm.dxf
221.0 x 181.0 mm
