Houman1368/Waste/uvc-arm-stand/step/parts/A2_end_caps.step

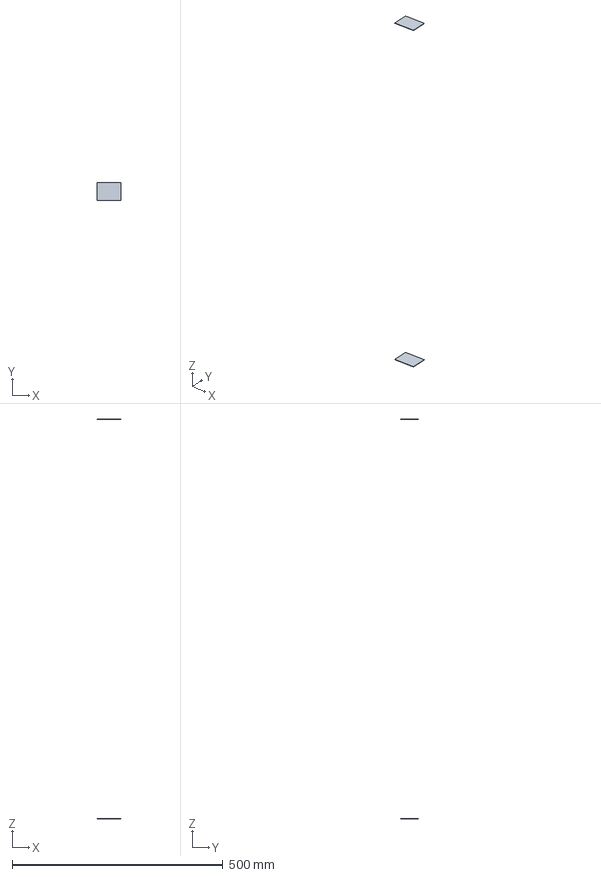
[picture p46: CAD file, 2026-10-09]
uvc-arm-stand/step/parts/A2_end_caps.step
58.0 x 43.0 x 950.0 mm
