Houman1368/Waste/uvc-arm-stand/step/parts/H1_bracket.step

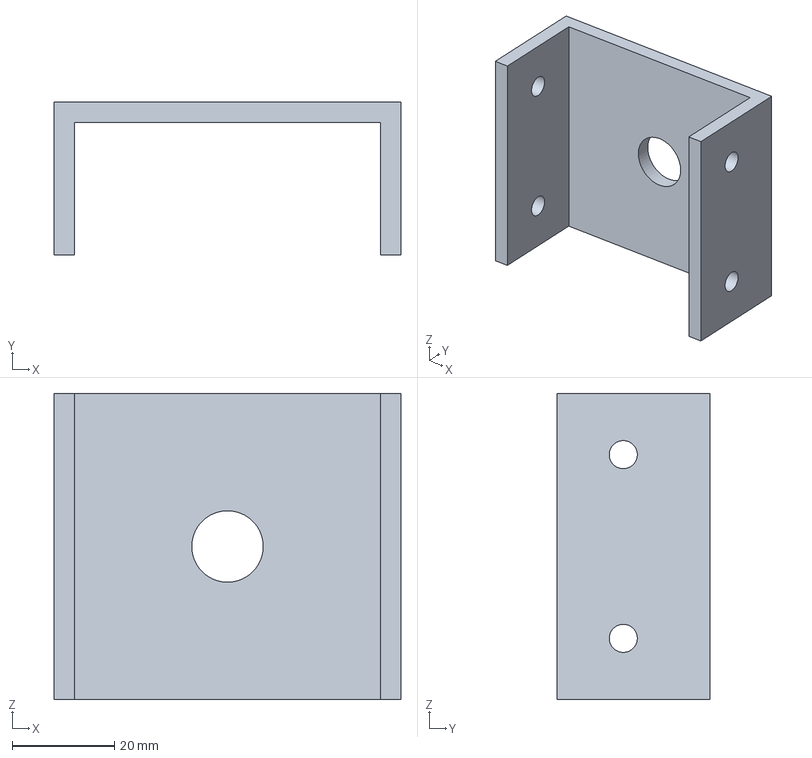
[picture p47: CAD file, 2026-10-09]
uvc-arm-stand/step/parts/H1_bracket.step
68.0 x 30.0 x 60.0 mm
