Houman1368/Waste/uvc-arm-stand/step/parts/T1_head_plate.step

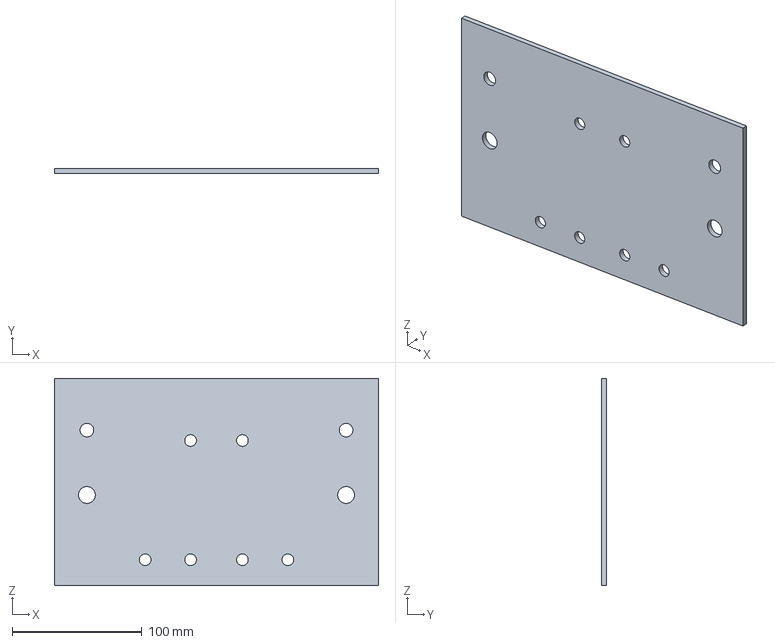
[picture p48: CAD file, 2026-10-09]
uvc-arm-stand/step/parts/T1_head_plate.step
250.0 x 4.00 x 160.0 mm
