Houman1368/Waste/uvc-arm-stand/step/parts/C1_gusset.step

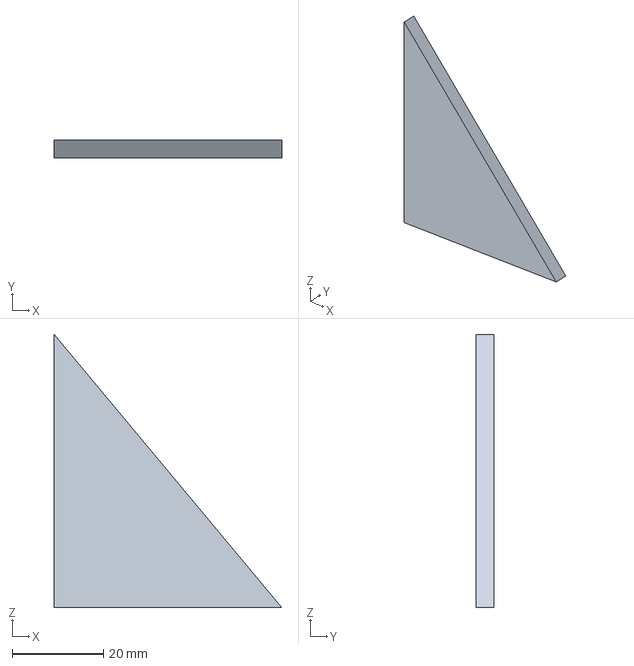
[picture p49: CAD file, 2026-10-09]
uvc-arm-stand/step/parts/C1_gusset.step
50.0 x 4.00 x 60.0 mm
