Houman1368/Waste/uvc-arm-stand/step/parts/C3_panel_box.step

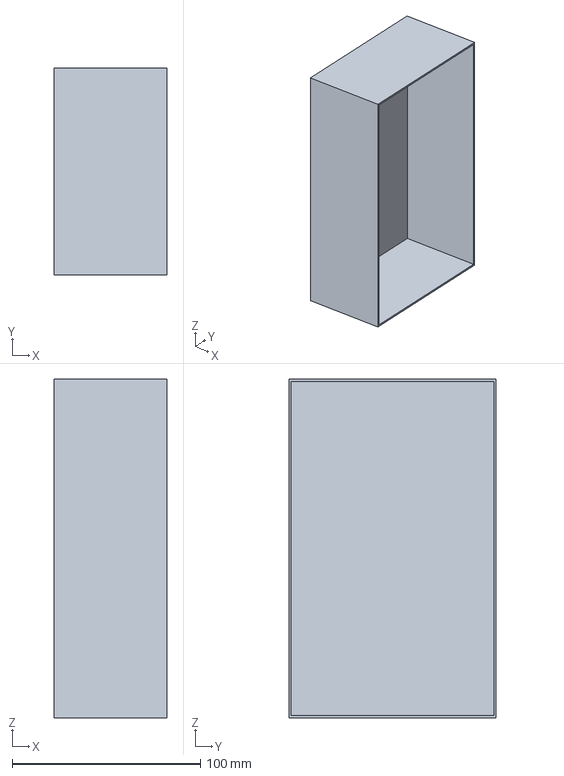
[picture p50: CAD file, 2026-10-09]
uvc-arm-stand/step/parts/C3_panel_box.step
60.0 x 110.0 x 180.0 mm
