Houman1368/Waste/uvc-arm-stand/step/parts/C1_column_tube.step

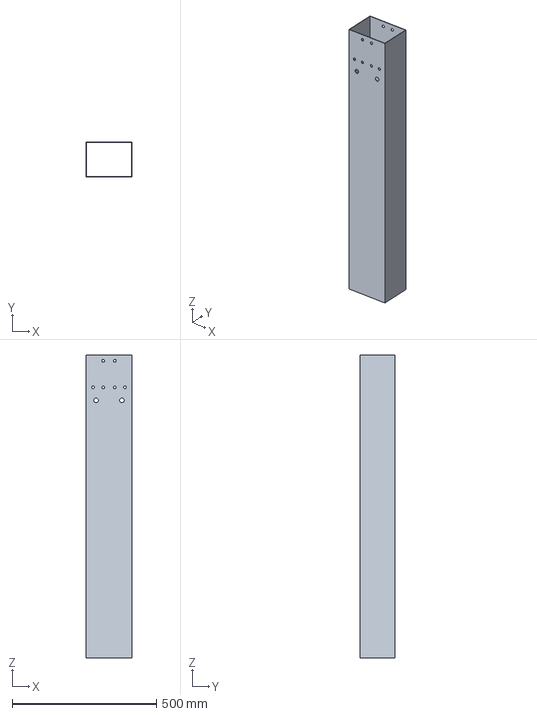
[picture p51: CAD file, 2026-10-09]
uvc-arm-stand/step/parts/C1_column_tube.step
160.0 x 120.0 x 1050.0 mm
