Houman1368/Waste/uvc-arm-stand/step/parts/C1_flange.step

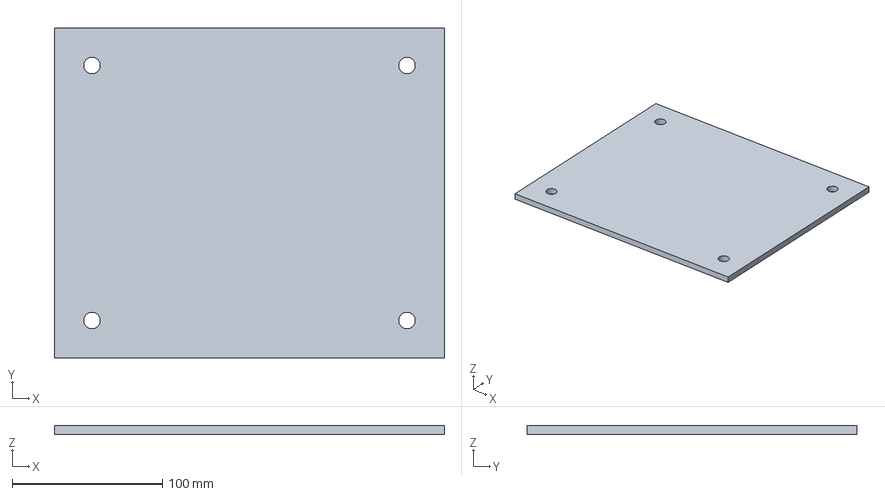
[picture p52: CAD file, 2026-10-09]
uvc-arm-stand/step/parts/C1_flange.step
260.0 x 220.0 x 6.00 mm
