Houman1368/Waste/(list of files, cad)

Other CAD files:
uvc-arm-stand/step/V2_parts/A2_end_caps.step
uvc-arm-stand/step/V2_parts/B1_base_plate.step
uvc-arm-stand/step/V2_parts/B2_ballast_box.step
uvc-arm-stand/step/V2_parts/C1_flange.step
uvc-arm-stand/step/V2_parts/C1_gusset.step
uvc-arm-stand/step/V2_parts/C1_top_cap.step
uvc-arm-stand/step/V2_parts/C2_service_door.step
uvc-arm-stand/step/V2_parts/H2_index_disc.step
