Houman1368/Waste/(commit log)

2026-10-09 Add parametric CAD model and fit check for 4-arm UV-C stand
    CadQuery model of all metal parts (as-drawn V1 and corrected V2),
    automated interference/stability checks over all 13 arm positions,
    STEP assemblies/parts for SolidWorks, DXF laser profiles, renders,
    and a Persian report of the issues found and fixes.
    Claude-Session: https://claude.ai/code/session_01325RCroXSJxJRZUJc7hoan
    [A1_arm_blank_1mm_x4.dxf, A1_arm_channel.step, A2_end_caps.step, B1_base_plate.step, B1_base_plate_6mm.dxf, B2_ballast_box.step, C1_column_tube.step, C1_flange.step]
2026-10-09 Add assembly and arm-motion animation of the UV-C stand
    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
2026-10-09 Consolidate to one final design and fix remaining issues
    - single design (removed as-drawn V1 model, images, STEP, landscape video)
    - hinges 200 apart, M12x1.5 index plunger (pin 6, rest position), index holes 6.2
    - 6 flush countersunk M8 screws per T1 into rivet nuts
    - M5 bracket bolts through channel side walls, cable grommets in arm and column
    - control panel on left side, vertical push handle on right side, door 120 wide
    - new DXFs (A2 end cap, C2 door), README rewritten as final build document
    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
    [A1_arm_blank_1mm_x4.dxf, A1_arm_channel.step, A2_end_cap_blank_1mm_x8.dxf, A2_end_caps.step, B1_base_plate.step, B1_base_plate_6mm.dxf, B2_ballast_box.step, C1_column_tube.step]
2026-10-09 Shopping/production PDF: two-phase plan with prototype test
    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
2026-10-09 Add full technical specification PDF with dimensioned shop drawings
    - drawings.py: dimensioned SVG drawings for every manufactured part, GA and wiring
    - specifications PDF: general specs, part drawings, electrical and hardware specs,
    fastener standards and torques, welding/tolerances/finish, acceptance tests
    - consistency: index holes 6.2, bush length 10.2, end cap with four flanges
    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
